deltax1099/DATN/Image/z3633867298325_d946b108812c51919a0d7c438a8485fa (1).jpg

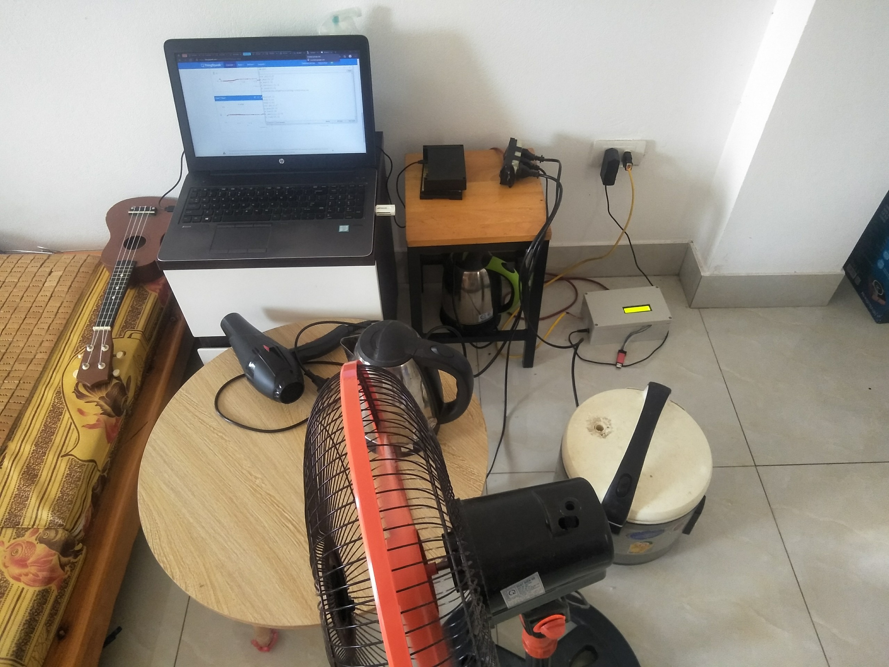
Image/z3633867298325_d946b108812c51919a0d7c438a8485fa (1).jpg
