deltax1099/DATN/Image/z3633789109134_f0cf5f153716a91d00ca48ec02b9b118.jpg

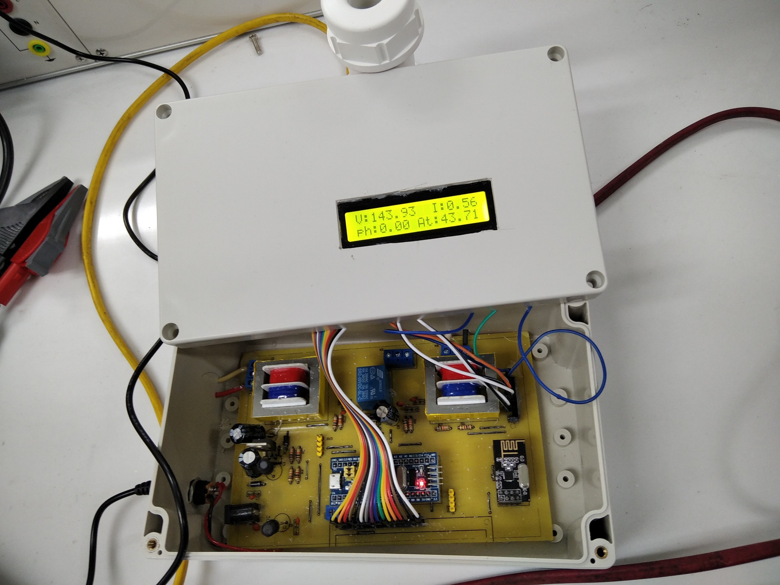
Image/z3633789109134_f0cf5f153716a91d00ca48ec02b9b118.jpg
