deltax1099/DATN/Document/note.pptx

LM2596T - 1N5819
AMS1117
R12: 10k
R13: 3k3
Bo sung word:
- Them khoi relay + bổ sung vào sơ đồ khối
- Gioi thieu cac giao thuc trong thiet ke phan mem nhung
- Thay doi ly thuyet cua phan thiet ke phan mem nhung (tinh toan
dai luong tren luoi dien) + thay đổi lưu đồ thuật toán
- Tài liệu tham khảo
- UI rms
- nguồn pin?
- U1 vs IN2? U2 vs IN1?
Nguon:
- Khong co cau chi bao ve trong truong hop qua dong/qua ap
- Dau vao jack DC cung khong co bao ve
- Jack DC dat o sau ic 5V => chi cung cap cho cac nguon 3.3V?
=> bien dong khong duoc cung cap => how to measure?
Bien dong:
- Khong cach li o bien dong => neu bien dong chay => chay thiet bi?

## Slide 2

EEPROM:
- Phan A tong, A luoi luu tren RAM neu mat dien thi mat luon? Neu gia tri qua lon thi bi tran?
Gateway:
- Them tin hieu nut nhan de dieu khien relay
Lưu đồ tt:
- Làm lại lưu đồ thuật toán chuẩn
- Giải thích code (từng dòng)
PCB:
- Do dong phan nguon va phan tin hieu
- Vẽ lại PCB của mạch để đo theo phương pháp chuẩn
Ứng dụng:
- Lắp đặt thiết bị như thế nào trong hệ thống nhà?

## Slide 3

- Thêm khối relay + bổ sung vào sơ đồ khối
- Thêm phần pcb theo phương pháp chuẩn
- Thử nghiệm sai số đo chính xác
- Làm rõ tương quan thời điểm lấy mẫu u và I
- Làm rõ sử dụng Arduino trên gateway
- Làm rõ việc không tập trung vào độ chính xác mà tập trung xây dựng chức năng
- Làm rõ việc thiết kế công tơ 2 chiều công suất
- Bổ sung kết quả trong lưới điện thông minh
- Làm rõ có thiết kế tính năng trong lưới điện thông minh
  - Lập chi tiết kịch bản thử nghiệm
  - Tiến hành lần lượt, có sơ đồ, chú thích trên ảnh
  - Cái nào chưa có thì ghi rõ thiếu thiết bị gì…
  - Hạn chế

## Slide 4

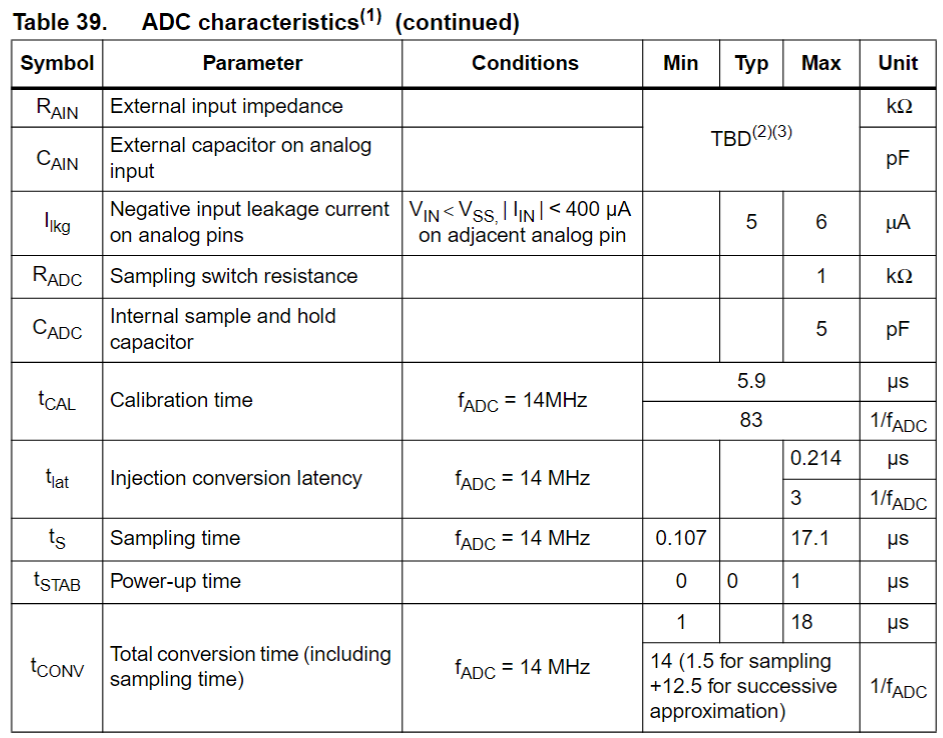
[picture p4: figure]
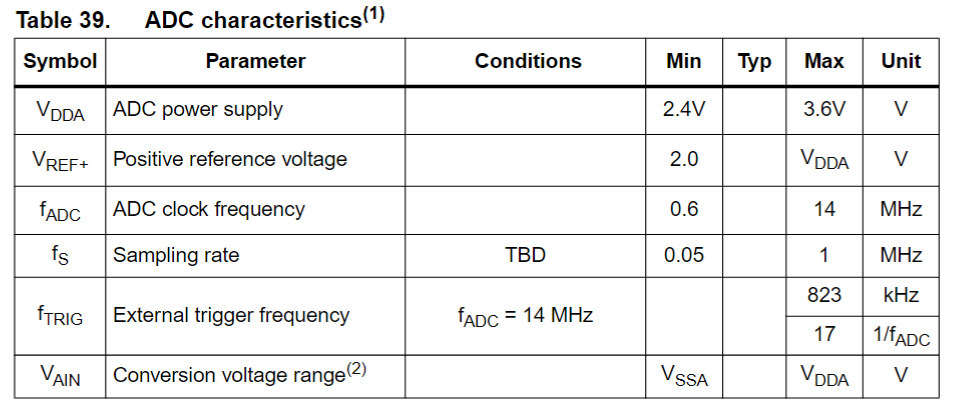
[picture p5: figure]
