deltax1099/DATN/Document/image-datn.pptx

Phân tích yêu cầu thiết kế

Thiết kế phần cứng và
phần mềm

Mô phỏng

Chế tạo thiết bị

Thử nghiệm và
đánh giá

## Slide 2

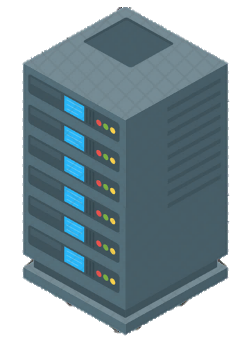
[picture p6: figure]
Data Storage Server Icon of Isometric style - Available in SVG, PNG, EPS, AI & Icon fonts

Server

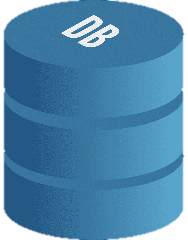
[picture p7: figure]
Round blue and white illustration, Database Server Icon, Database Symbol, template, user Interface Design, computer Program png | PNGWing

Database

Thành phần hệ thống

Thiết bị thu thập dữ liệu

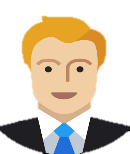
[picture p8: figure]

Công tơ điện

Công tơ điện

…

Quản lý

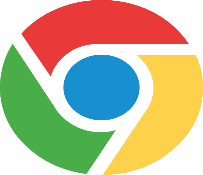
[picture p9: figure]

Web

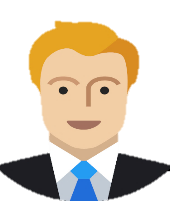
[picture p10: figure]

Web quản lý

Hộ gia đình

Web

Server

Công tơ điện

Công tơ điện

Cơ sở dữ liệu

Thiết bị thu thập dữ liệu

## Slide 3

THIẾT BỊ CÔNG TƠ ĐIỆN TỬ

Khối hiển thị

Khối nguồn

Khối SD Card

Khối đo dòng điện/điện áp

Khối điều khiển

Khối truyền thông RF

## Slide 4

Khối nguồn

5V

5V

3.3V

5V

3.3V

Khối hiển thị

Khối đo dòng điện/điện áp

I2C

MCU
STM32F1

SPI

Khối SD Card

Khối truyền thông RF

ADC

SPI

## Slide 5

THIẾT BỊ THU THẬP DỮ LIỆU

Khối điều khiển

Khối truyền thông Wifi

Khối truyền thông RF

## Slide 6

Nguồn

3.3V

3.3V

3.3V

MCU
Arduino Uno

UART

Khối truyền thông Wifi

Khối truyền thông RF

SPI

## Slide 7

Khối đo

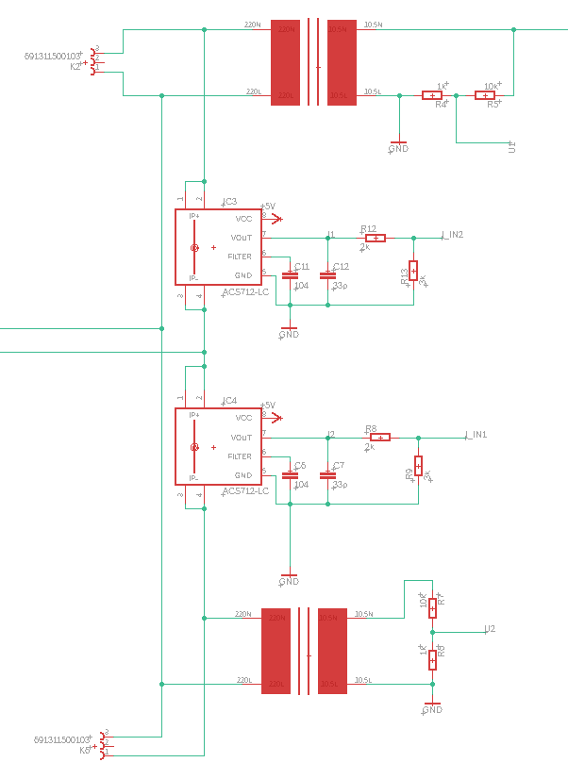
[picture p11: figure]

Nguồn

## Slide 8

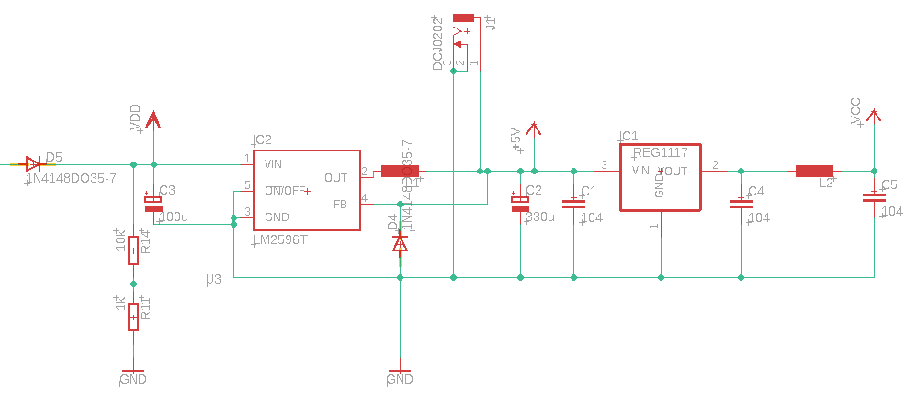
[picture p12: figure]

## Slide 9

Nguồn MT

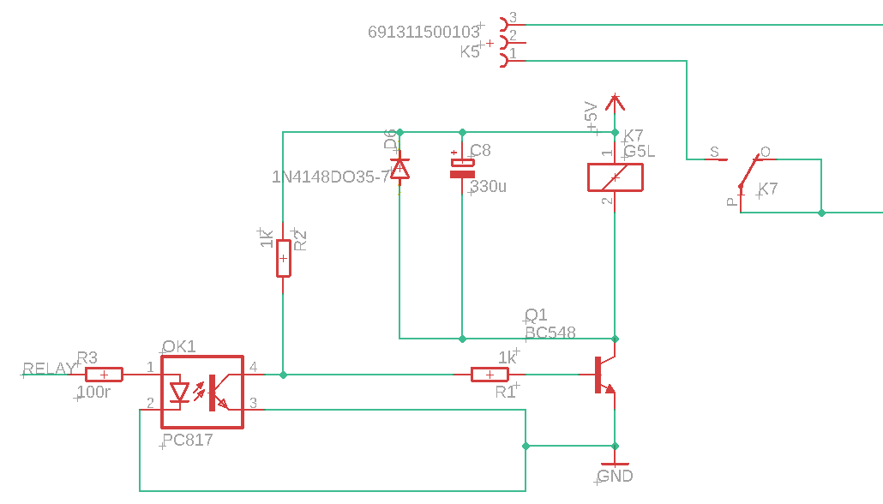
[picture p13: figure]

## Slide 10

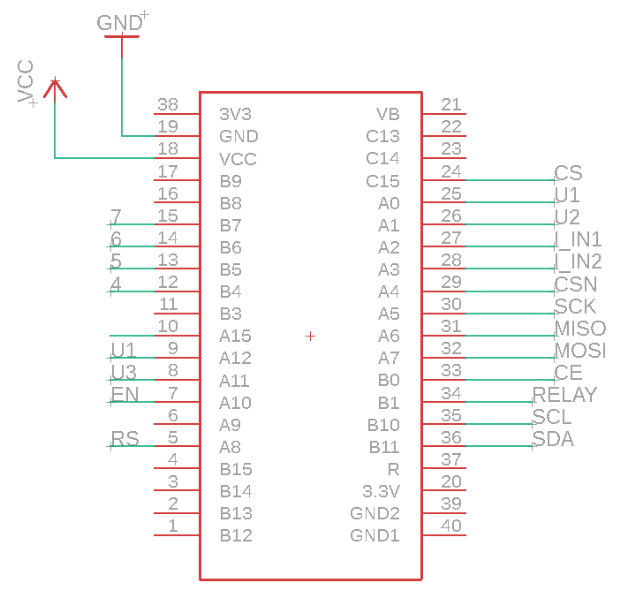
[picture p14: figure]
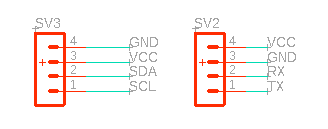
[picture p15: figure]

## Slide 11

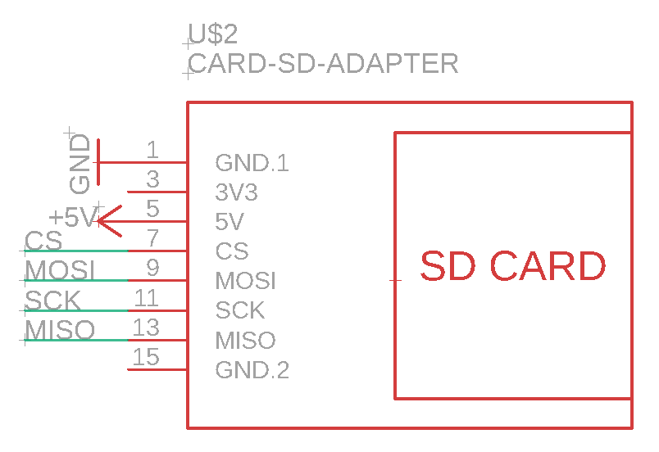
[picture p16: figure]
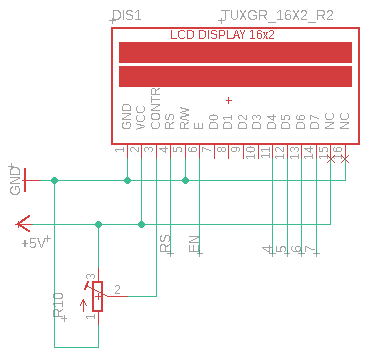
[picture p17: figure]
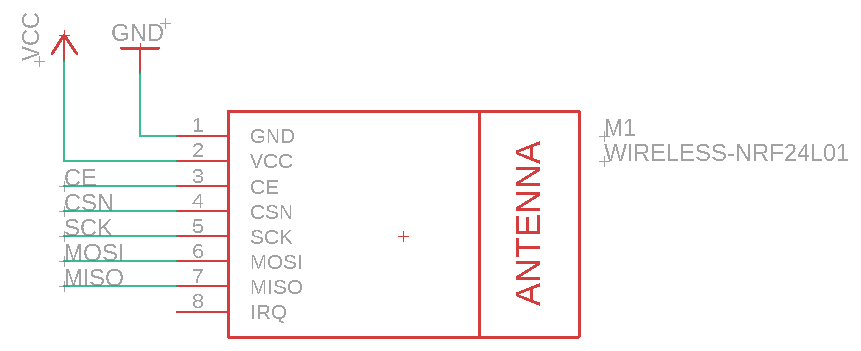
[picture p18: figure]

## Slide 12

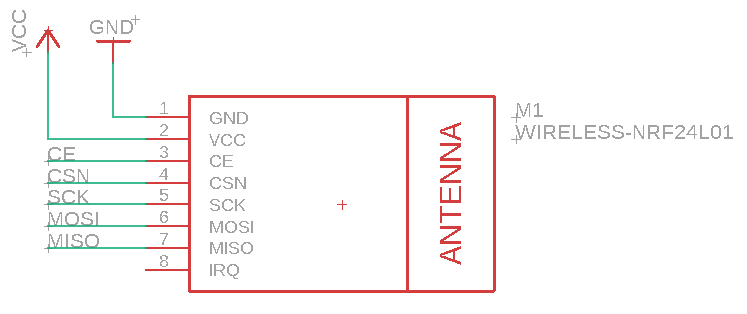
[picture p19: figure]

ESP8266

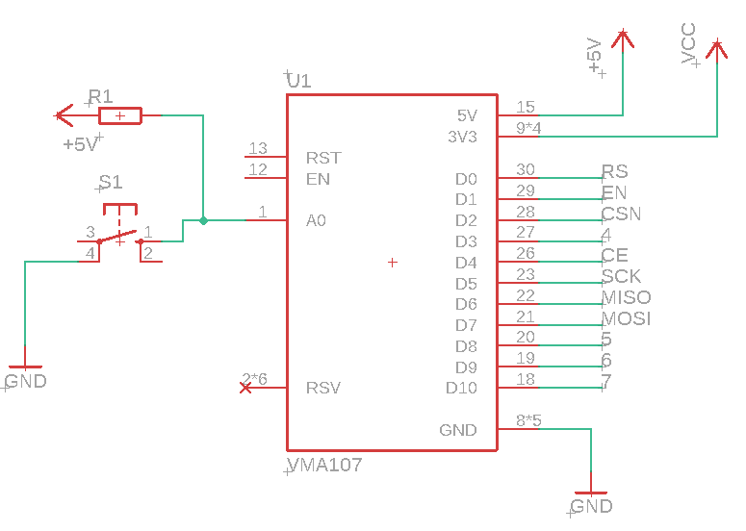
[picture p20: figure]
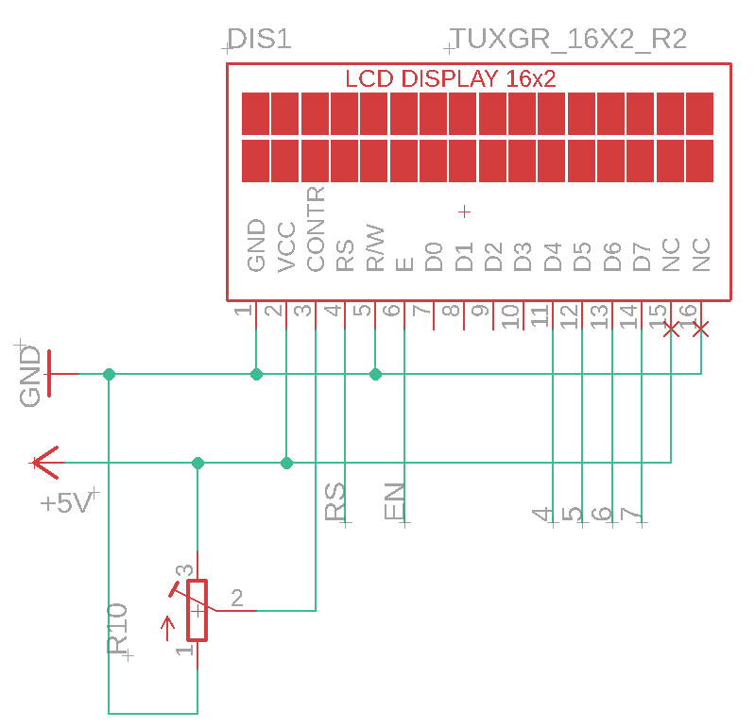
[picture p21: figure]

## Slide 13

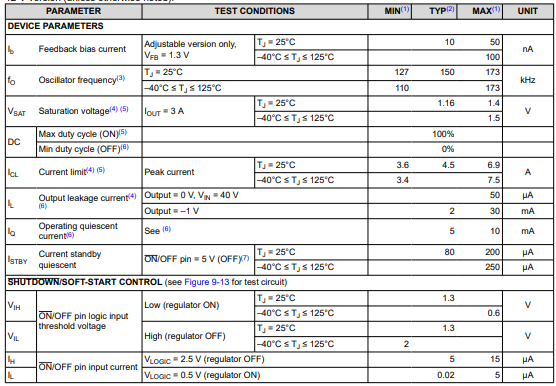
[picture p22: figure]

## Slide 14

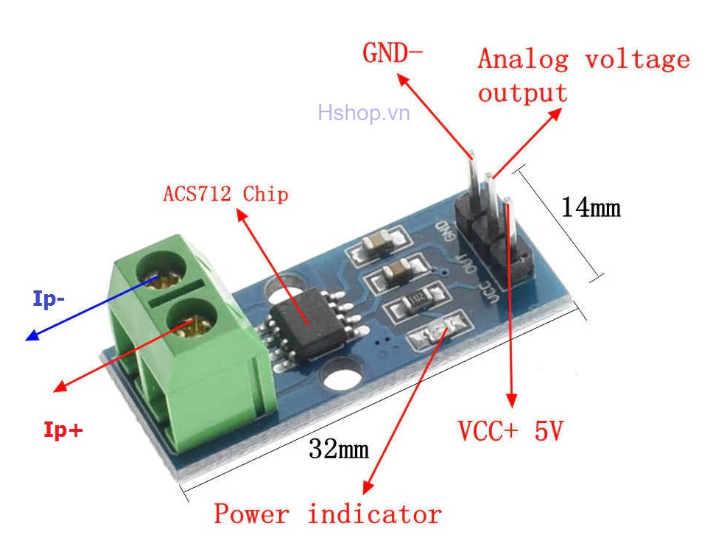
[picture p23: figure]

## Slide 15

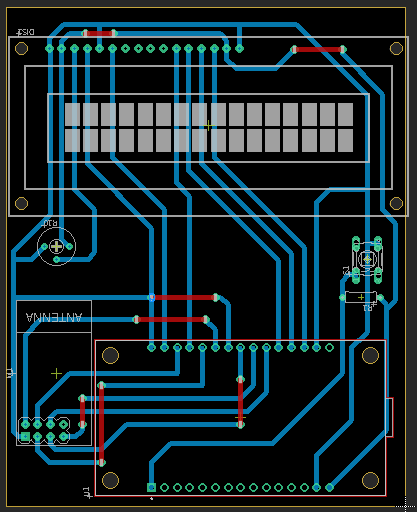
[picture p24: figure]
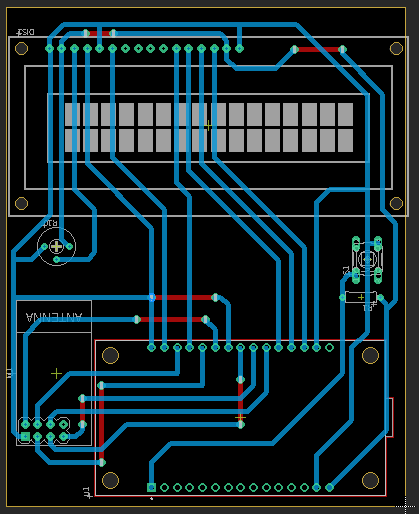
[picture p25: figure]

## Slide 16

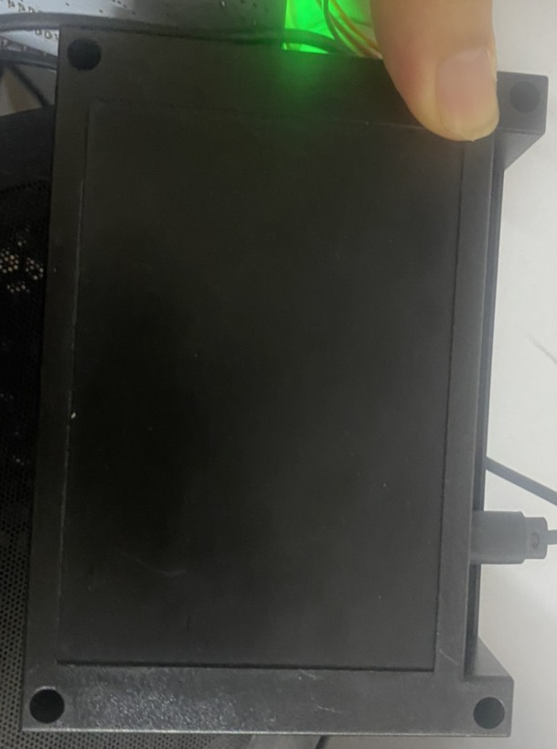
[picture p26: figure]
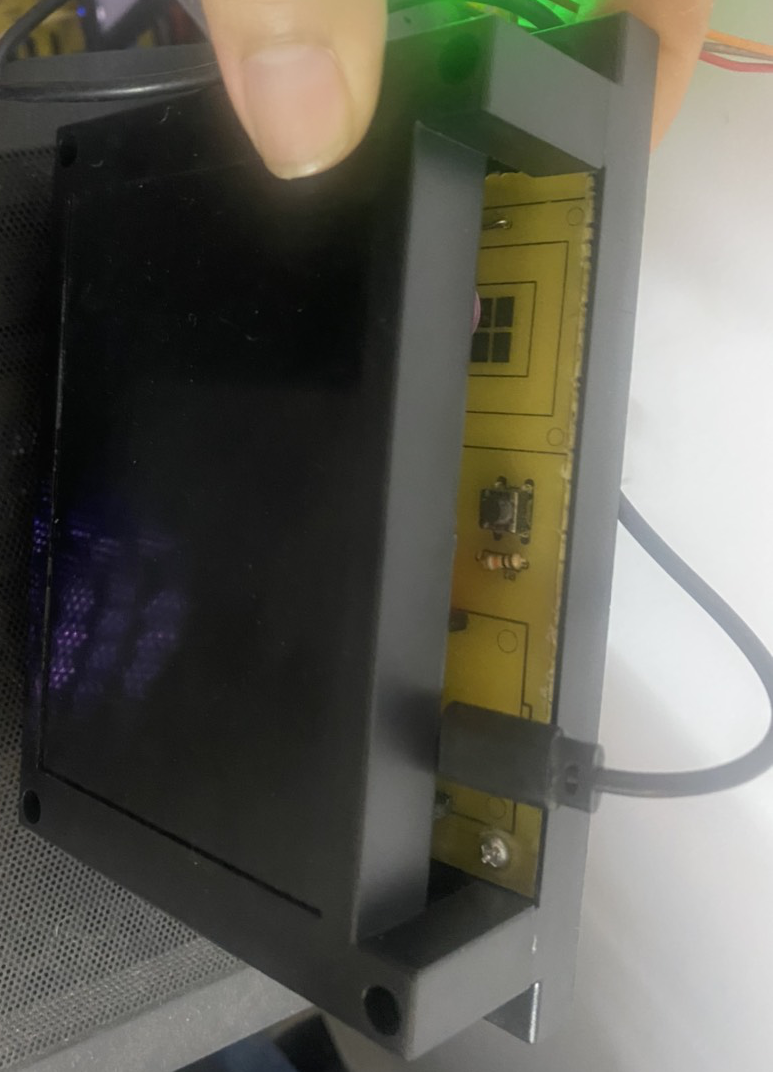
[picture p27: figure]

## Slide 17

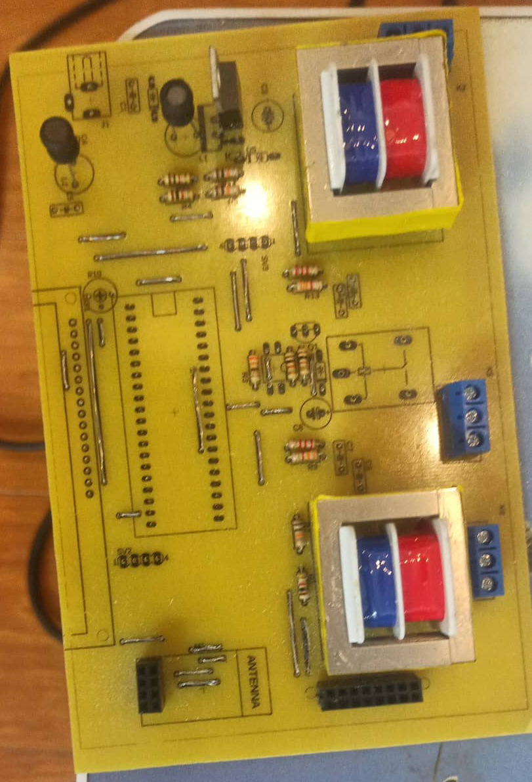
[picture p28: figure]
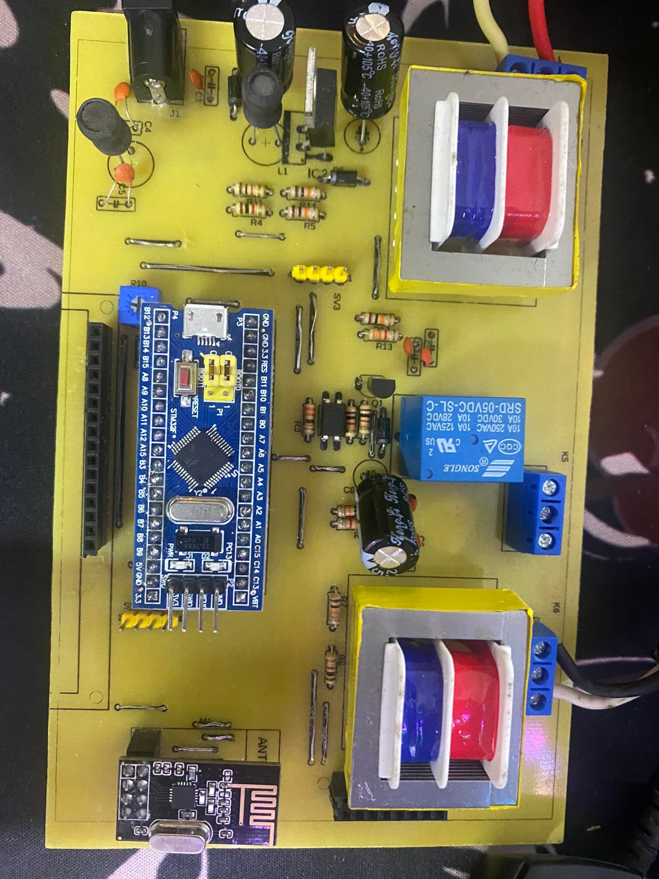
[picture p29: figure]

Trên lưới dưới tải

## Slide 18

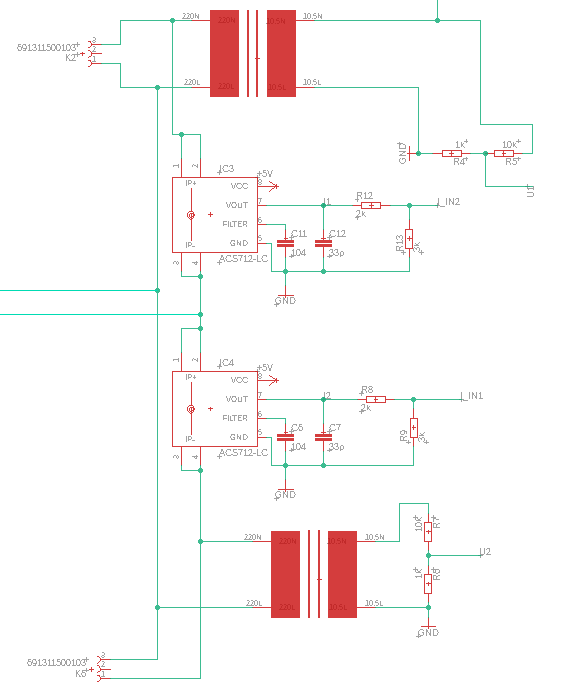
[picture p30: figure]

## Slide 19

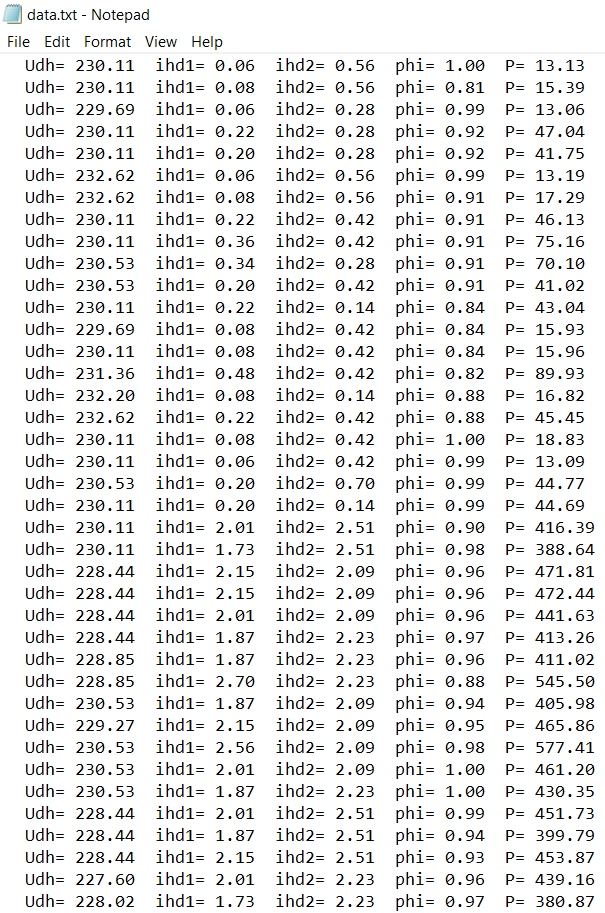
[picture p31: figure]
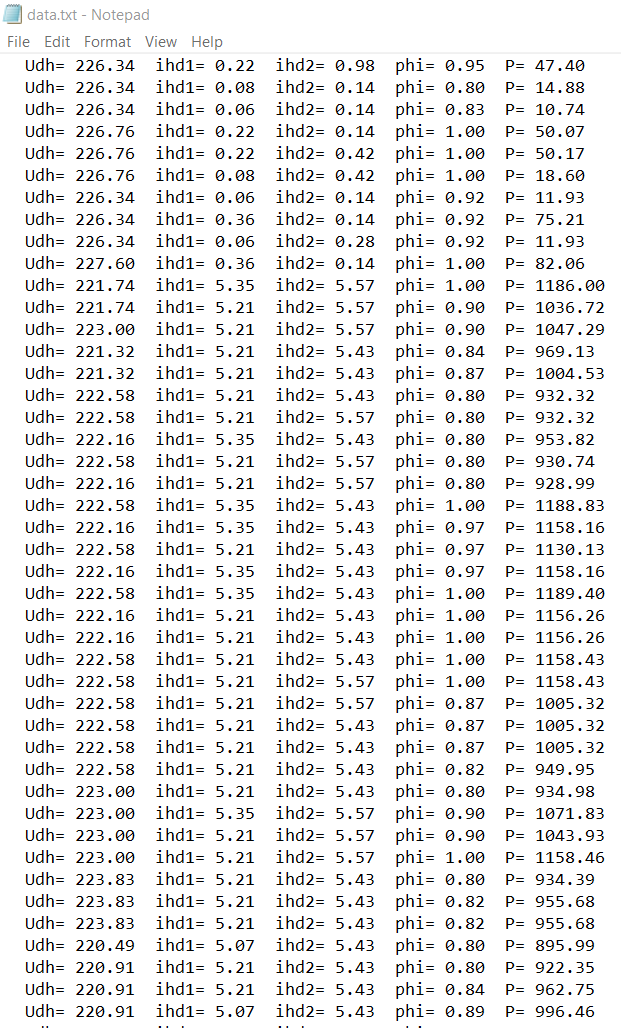
[picture p32: figure]

## Slide 20

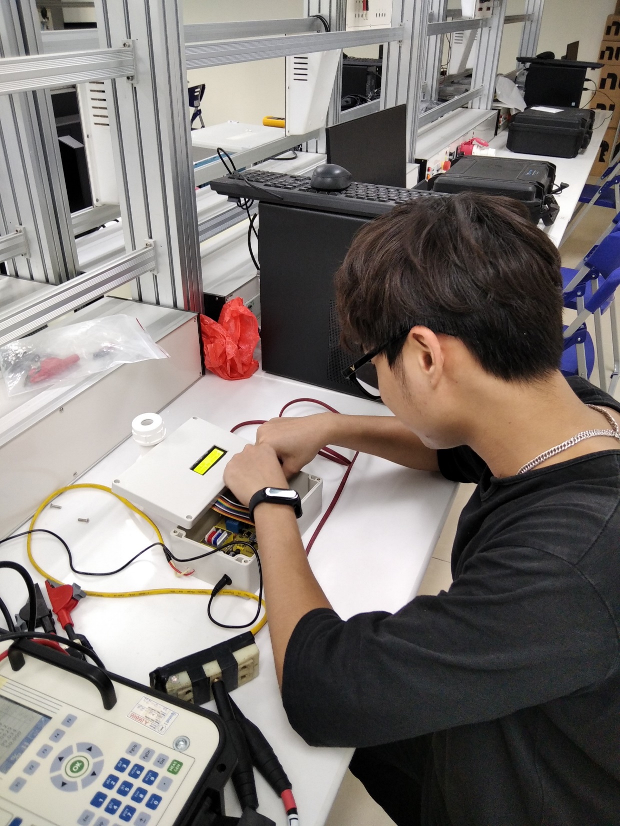
[picture p33: figure]
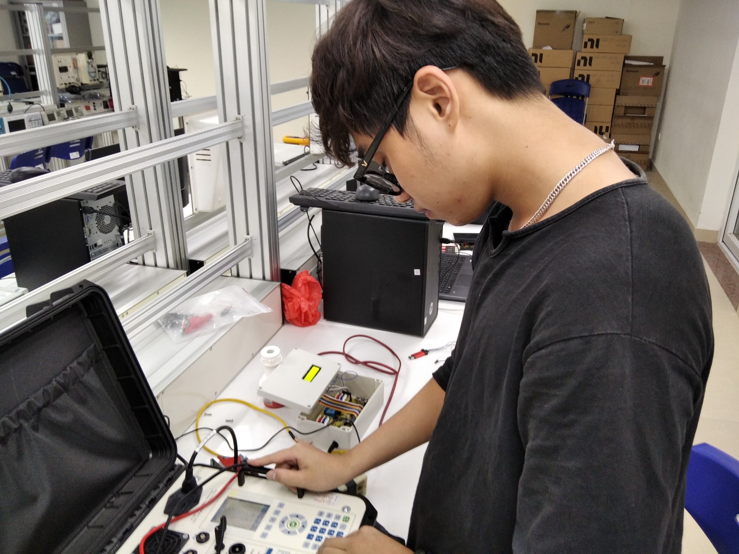
[picture p34: figure]

## Slide 21

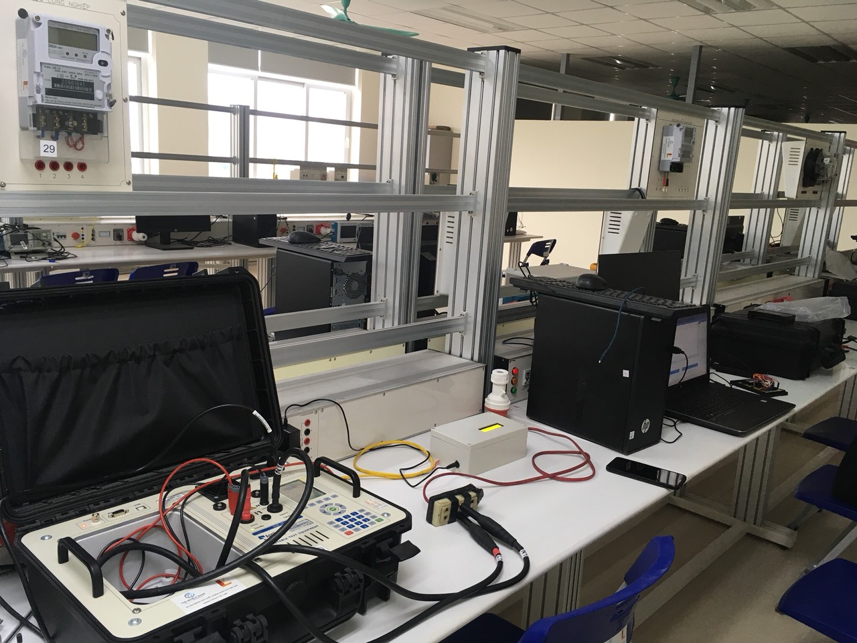
[picture p35: figure]

## Slide 22

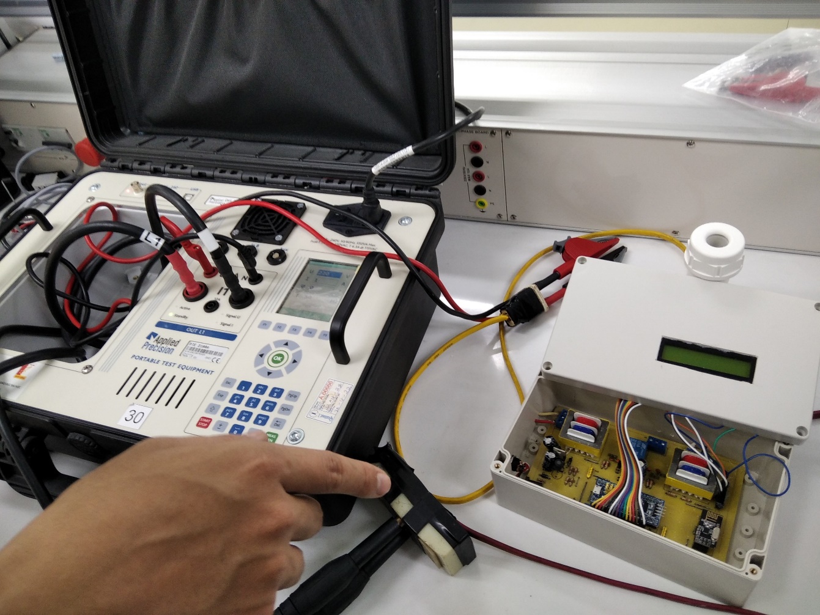
[picture p36: figure]
