deltax1099/DATN/Document/ĐATN_PPTX.pptx

## Đồ án tốt nghiệp Thiết kế công tơ điện tử trong hệ thống lưới điện thông minh

Giáo viên hướng dẫn: PGS.TS Hoàng Sĩ Hồng

Sinh viên thực hiện: Trần Anh Dũng – 20173785

## Table of Contents 01

Mục lục

02

Tổng quan đề tài

Thiết kế hệ thống

03

04

Thiết kế phần cứng

Thiết kế phần mềm

05

## I. Tổng quan đề tài

Tổng quan công nghệ

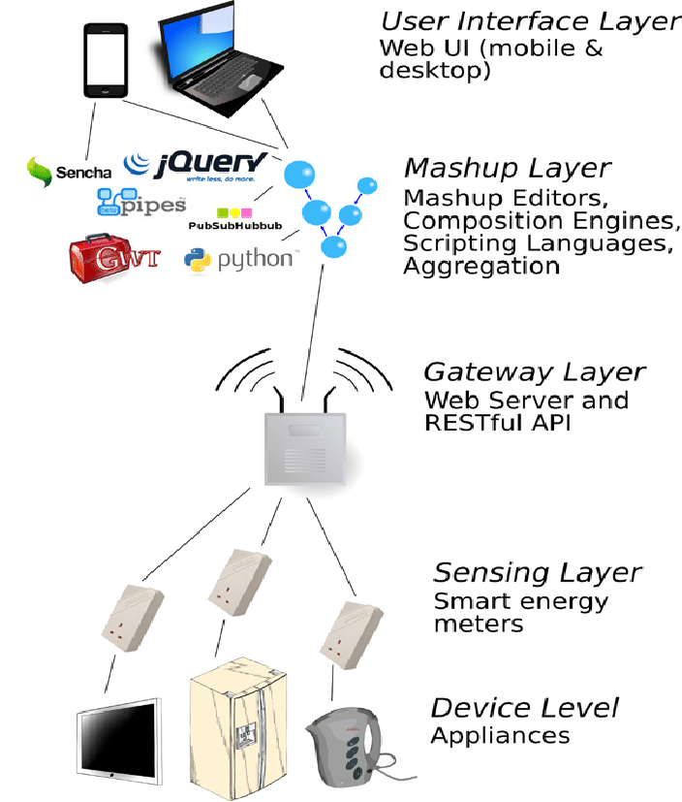
[picture p37: figure]

- Công nghệ IoT ngày càng phát triển
- Công tơ điện truyền thống hiện nay còn nhiều hạn chế

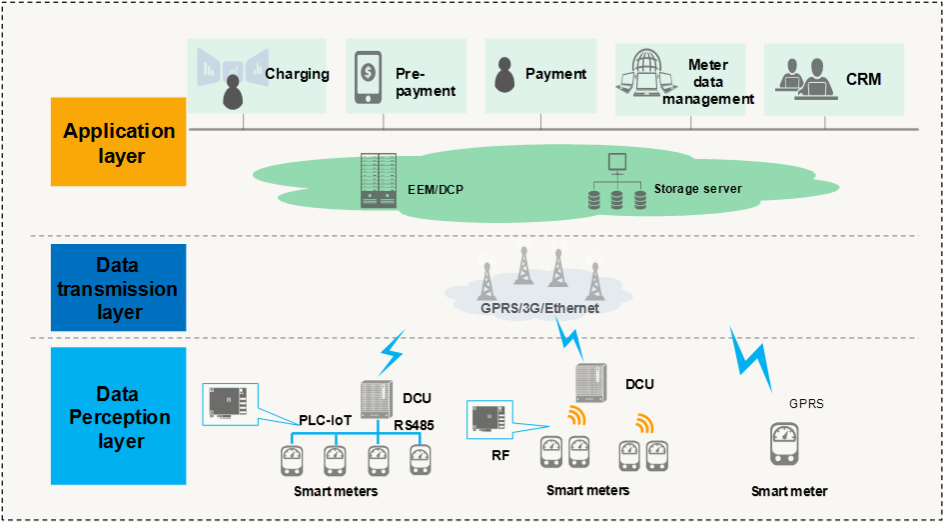
[picture p38: figure]

## I. Tổng quan đề tài

Tổng quan hệ thống

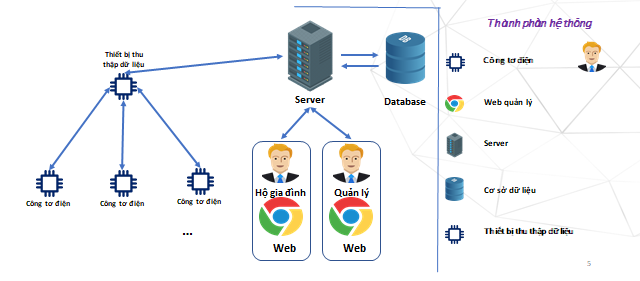
[picture p39: figure]

## II. Thiết kế hệ thống

Sơ đồ khối hệ thống

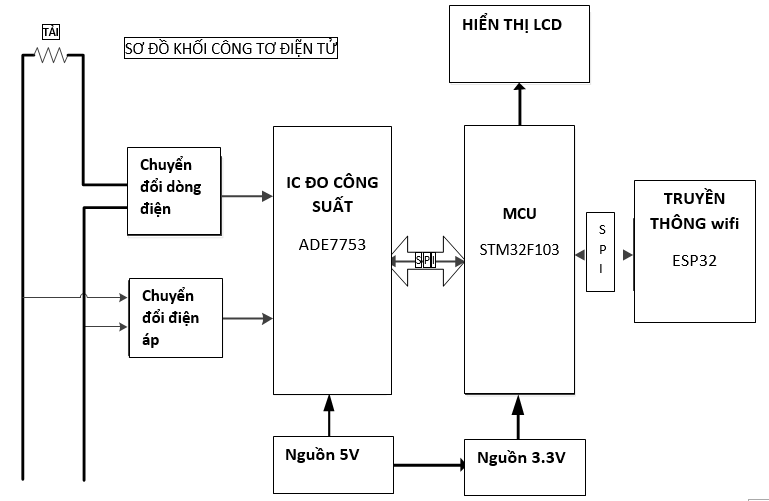
[picture p40: figure]

## III.Thiết kế phần cứng – 1. Khối nguồn

Sơ đồ nguyên lý

- Tích hợp trực tiếp trong bo mạch (lấy trực tiếp từ nguồn lưới điện 220V).
- Đầu vào: 220VAC
- Đầu ra: 5VDC cho mạch ADE7753, khối LCD và 3.3VDC cho mạch STM32F103 và khối truyền thông ESP32.

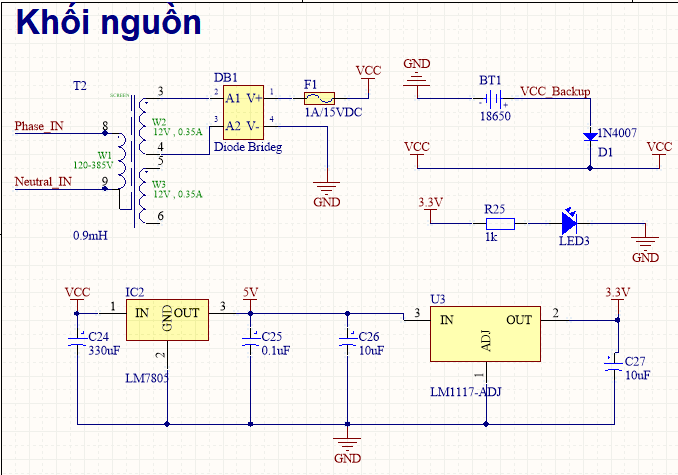
[picture p41: figure]

## III.2. Khối vi điều khiển

Sơ đồ nguyên lý

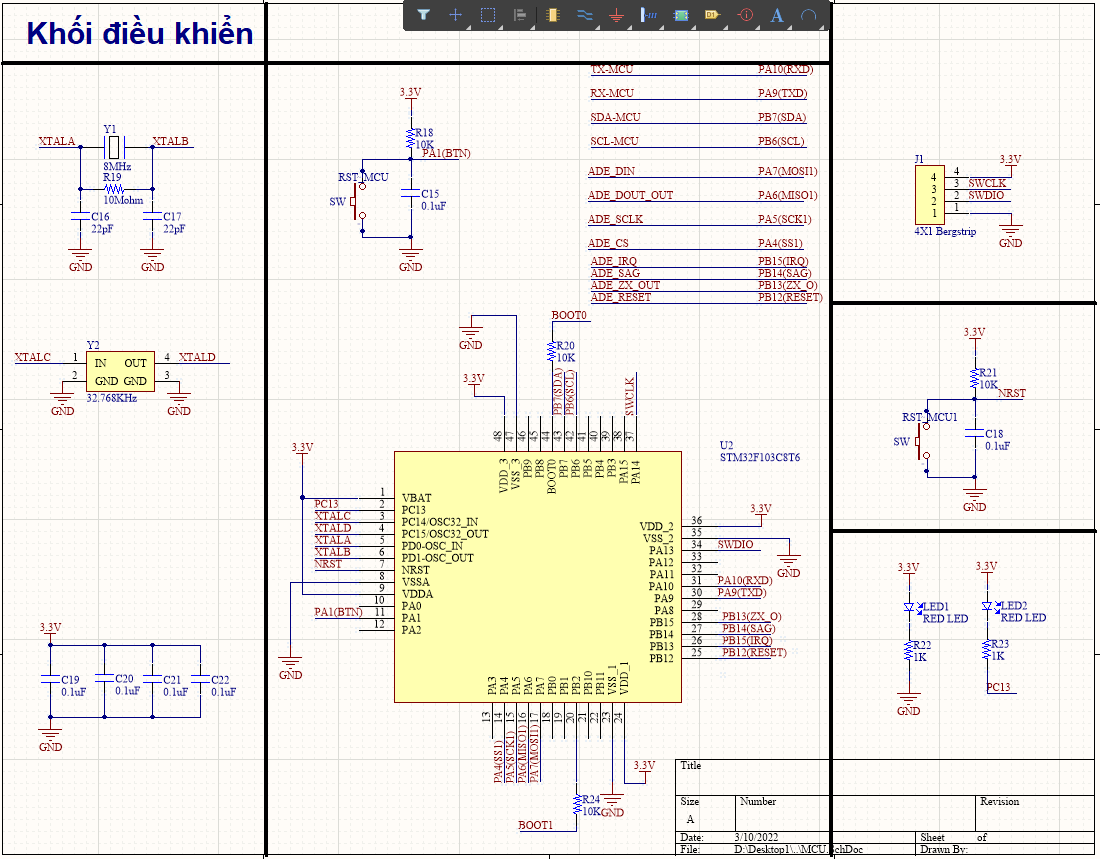
[picture p42: figure]

- Có tối thiểu 1 cổng giao tiếp SPI để kết nối với ADE7753 và 1 cổng UART để kết nối với modul ESP32.
- Có RTC bên trong Chip để phục vụ việc tính toán điện năng tiêu thụ theo biểu giá.
- Tiêu thụ điện năng thấp.
- Giá thành hợp lý.

## III.3. Khối chuyển đổi dòng điện – điện áp

Sơ đồ nguyên lý

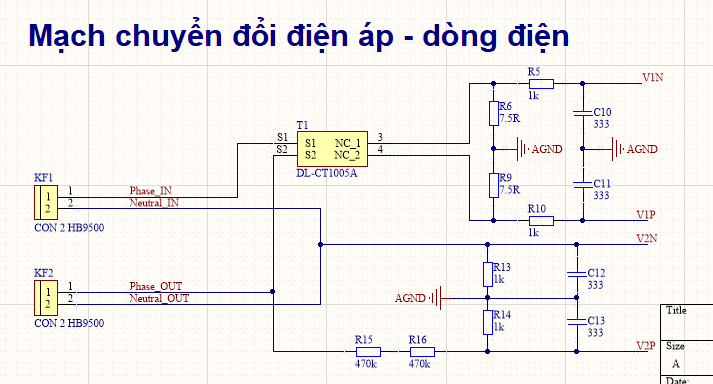
[picture p43: figure]

## III.4. Khối IC đo công suất ADE7753

Sơ đồ nguyên lý

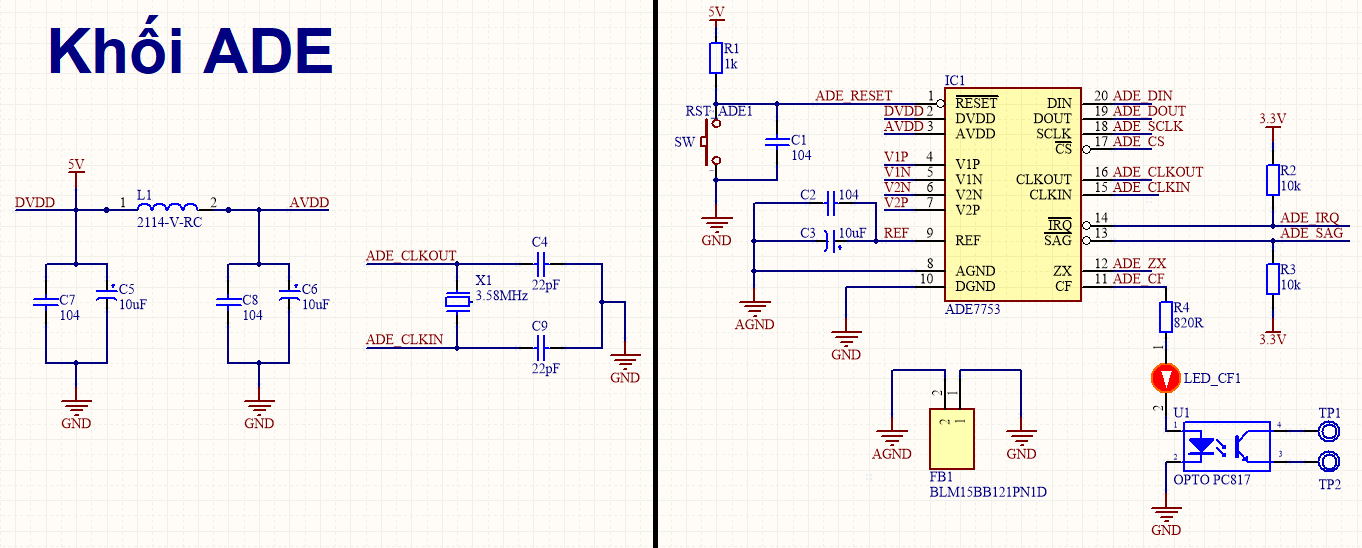
[picture p44: figure]
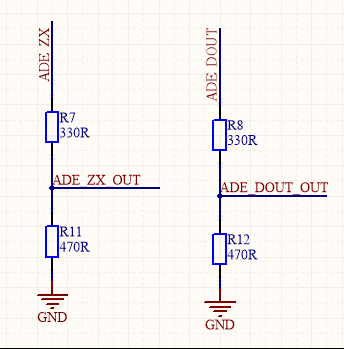
[picture p45: figure]

## III.5. Khối hiển thị

Sơ đồ nguyên lý

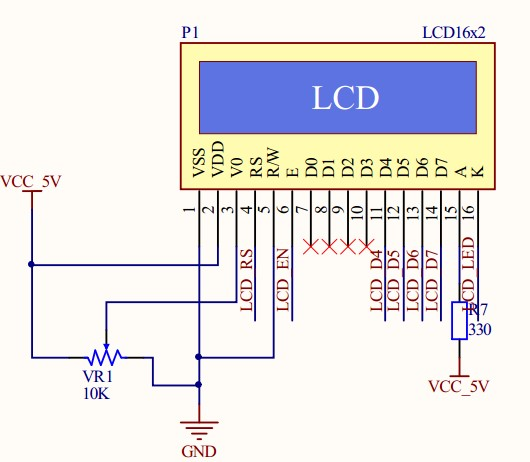
[picture p46: figure]

## III.6. Khối truyền thông không dây

Sơ đồ nguyên lý

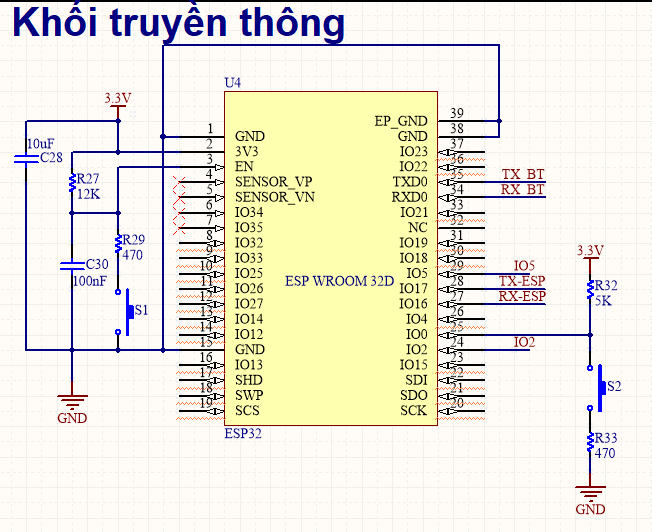
[picture p47: figure]
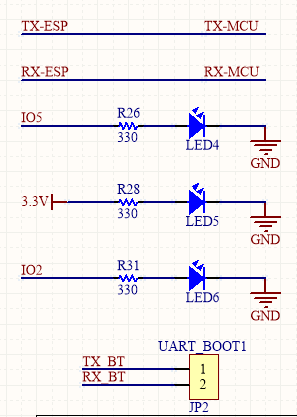
[picture p48: figure]

## IV. Thiết kế phần mềm

Lưu đồ thuật toán chương trình chính

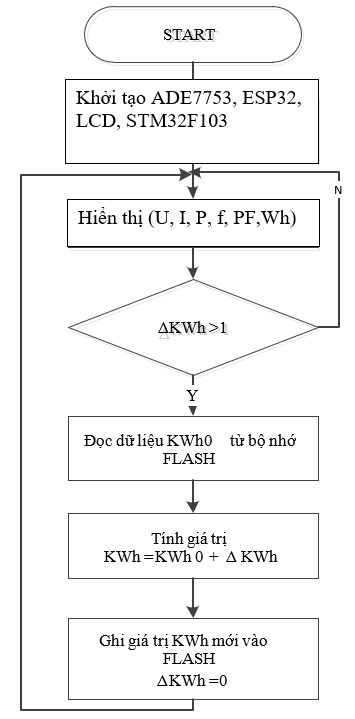
[picture p49: figure]

Gửi dữ liệu qua ESP32

## IV. Thiết kế phần mềm

Lưu đồ thuật toán chương trình ngắt phục vụ tính toán các đại lượng của công tơ

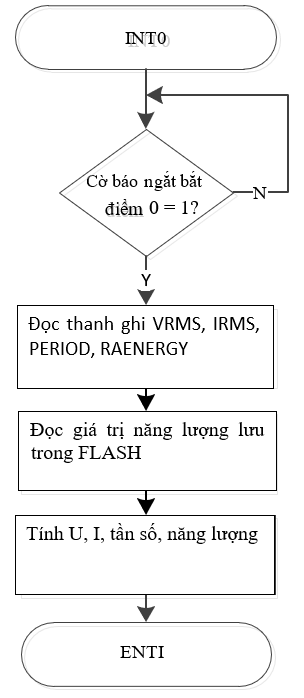
[picture p50: figure]

## IV. Thiết kế phần mềm

Lưu đồ thuật toán chương trình gửi dữ liệu lên server của ESP32

START

Khởi tạo UART, truyền thông wifi, MQTT service

- Sử dụng hệ điều hành RTOS
- 2 tác vụ: UART Task nhận dữ liệu từ vi điều khiển và MQTT Task gửi dữ liệu lên server

UART Task

Rx Buffer nhận data

Gửi vào Global Buffer

MQTT Task

Global Buffer nhận data

Gửi lên Server bằng mqttsend()

NO

NO

YES

YES

## Slide 15

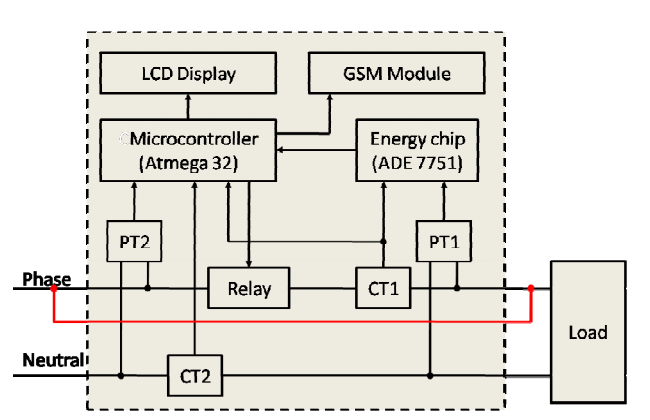
[picture p51: figure]
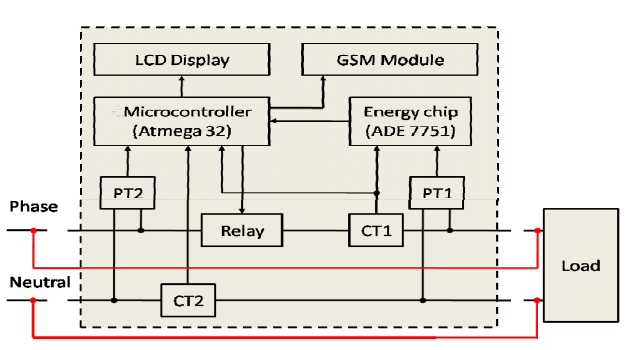
[picture p52: figure]

## Slide 16

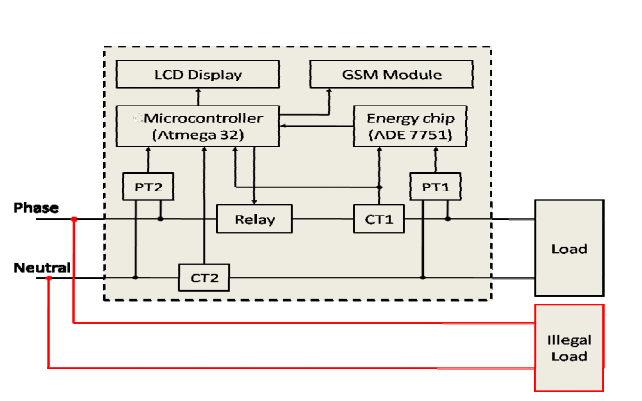
[picture p53: figure]
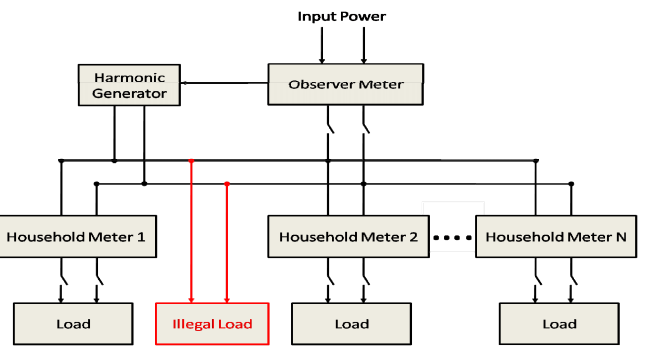
[picture p54: figure]

## Slide 17

THANKS FOR WATCHING!
