deltax1099/DATN/Image/Blank_diagram.png

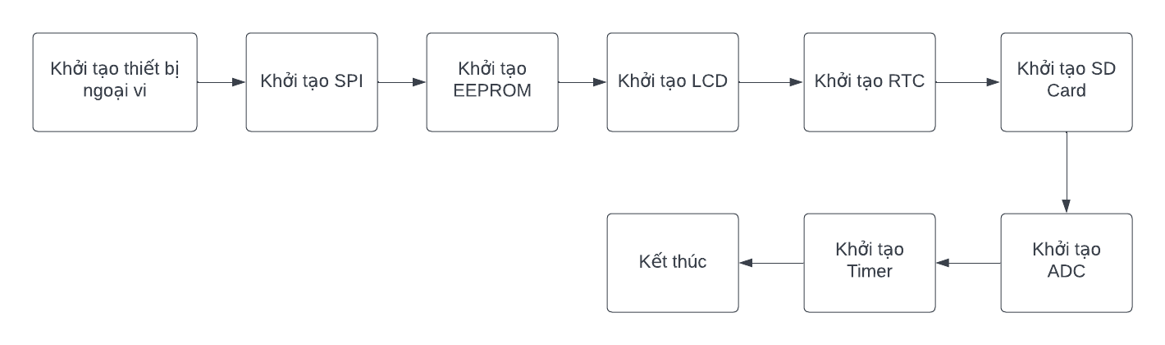
Image/Blank_diagram.png
