deltax1099/DATN/Image/diagram_esp.png

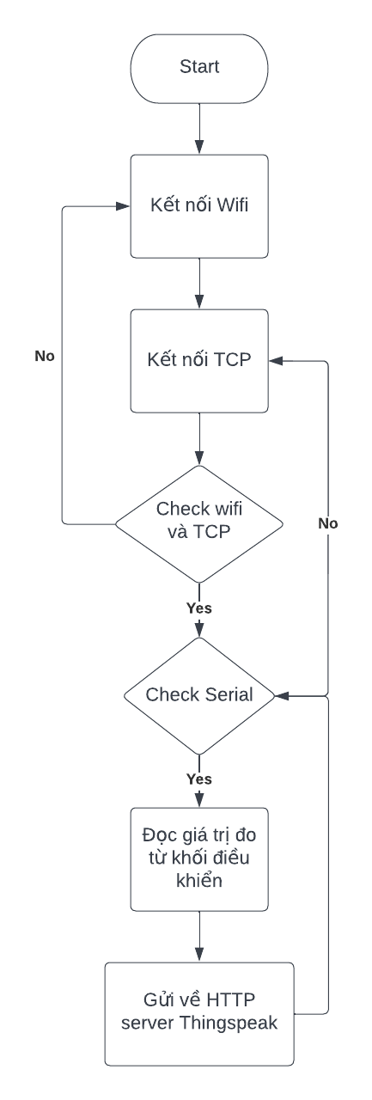
Image/diagram_esp.png
