deltax1099/DATN/Image/diagram_gateway.png

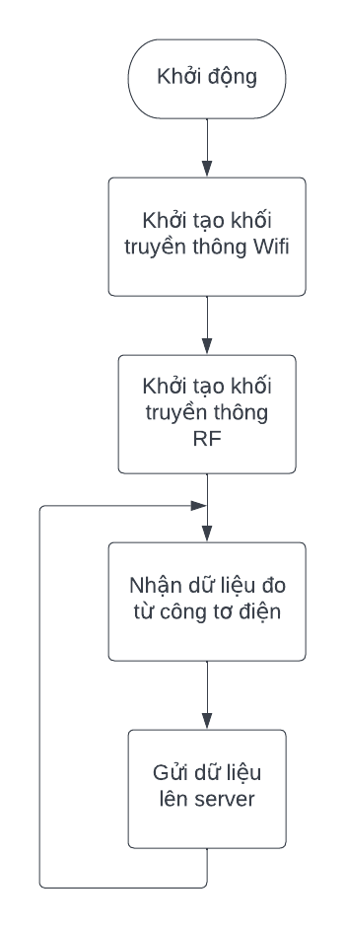
Image/diagram_gateway.png
