deltax1099/DATN/Image/diagram_meter1.png

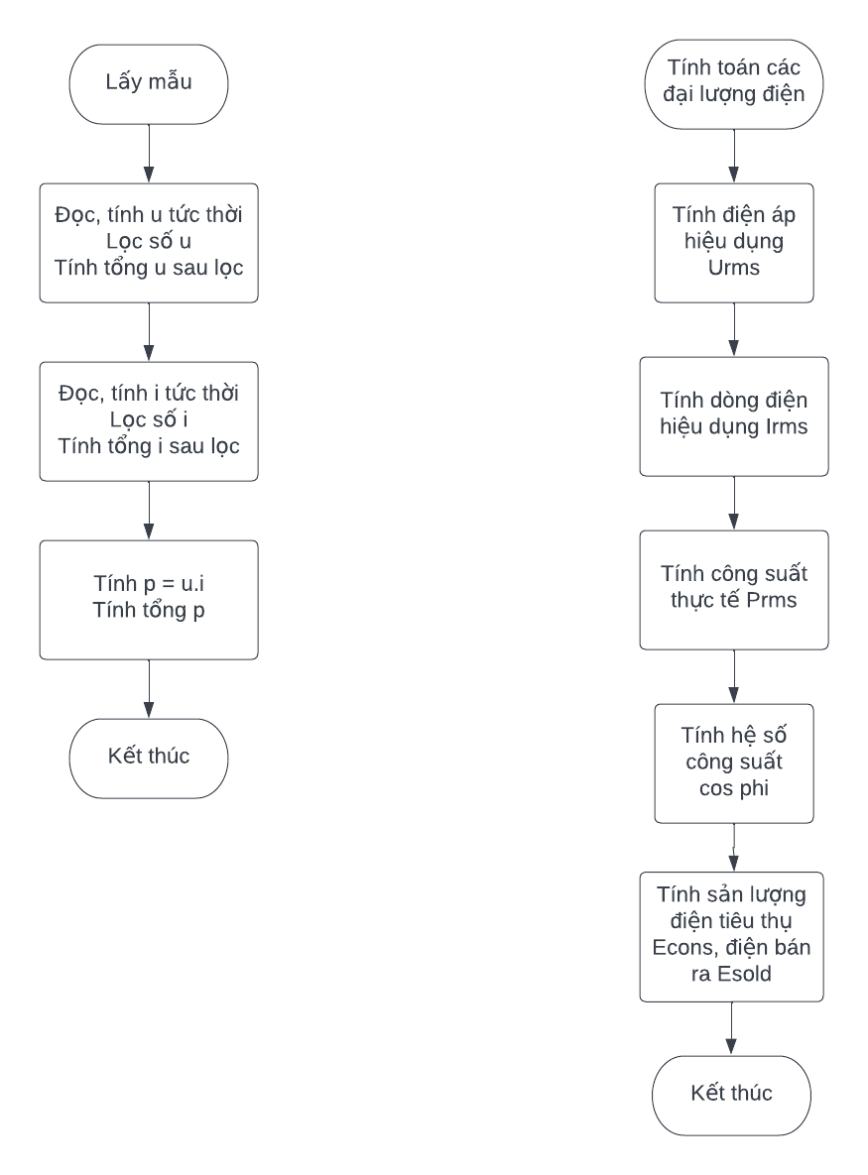
Image/diagram_meter1.png
