deltax1099/DATN/Image/diagram_meter.png

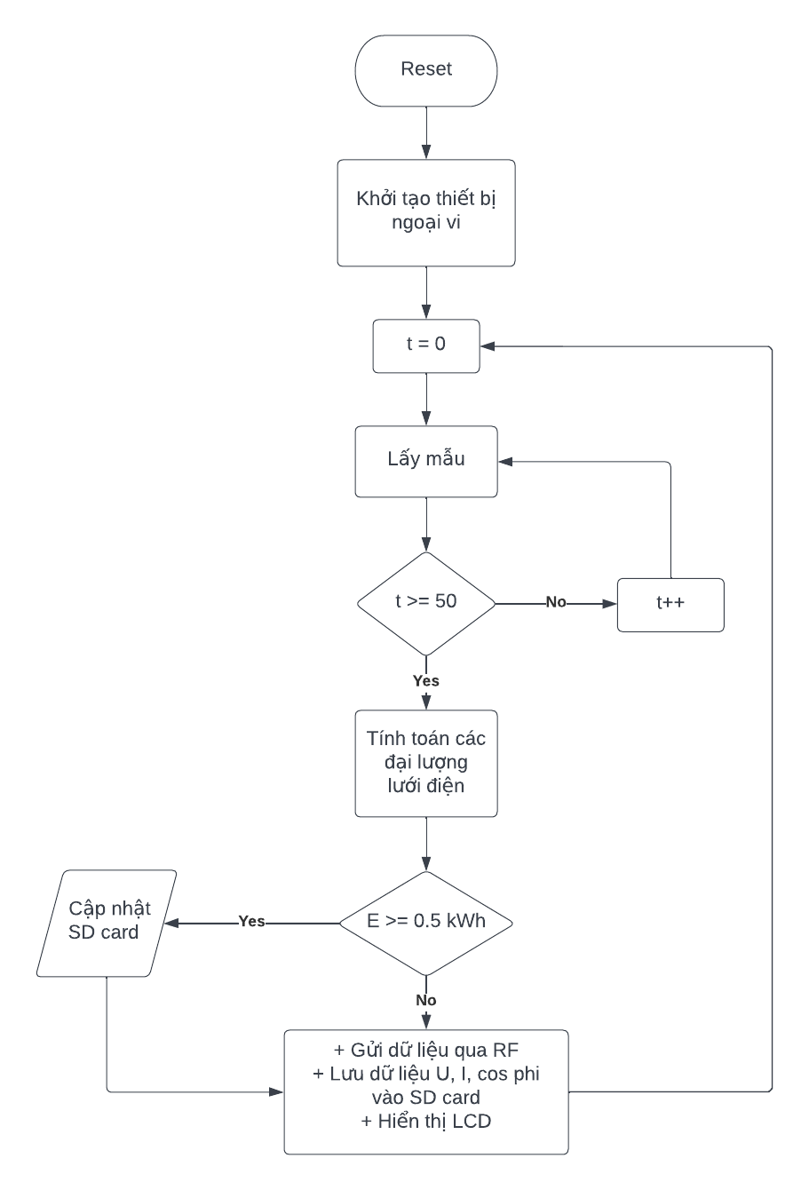
Image/diagram_meter.png
