deltax1099/DATN/Image/Gateway_dv1.jpg

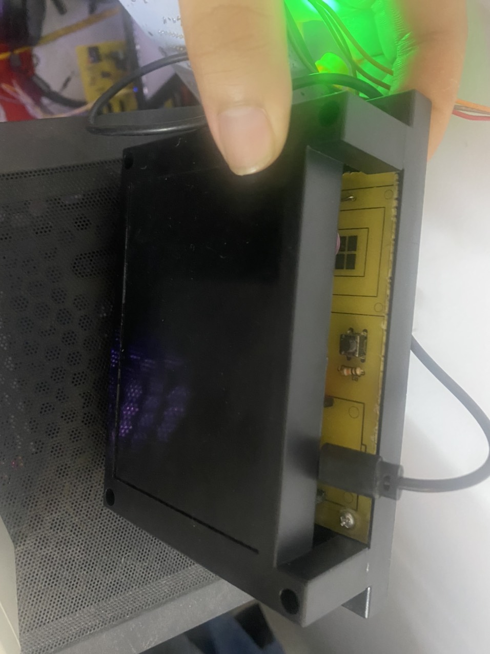
Image/Gateway_dv1.jpg
