deltax1099/DATN/Image/Gateway_dv.jpg

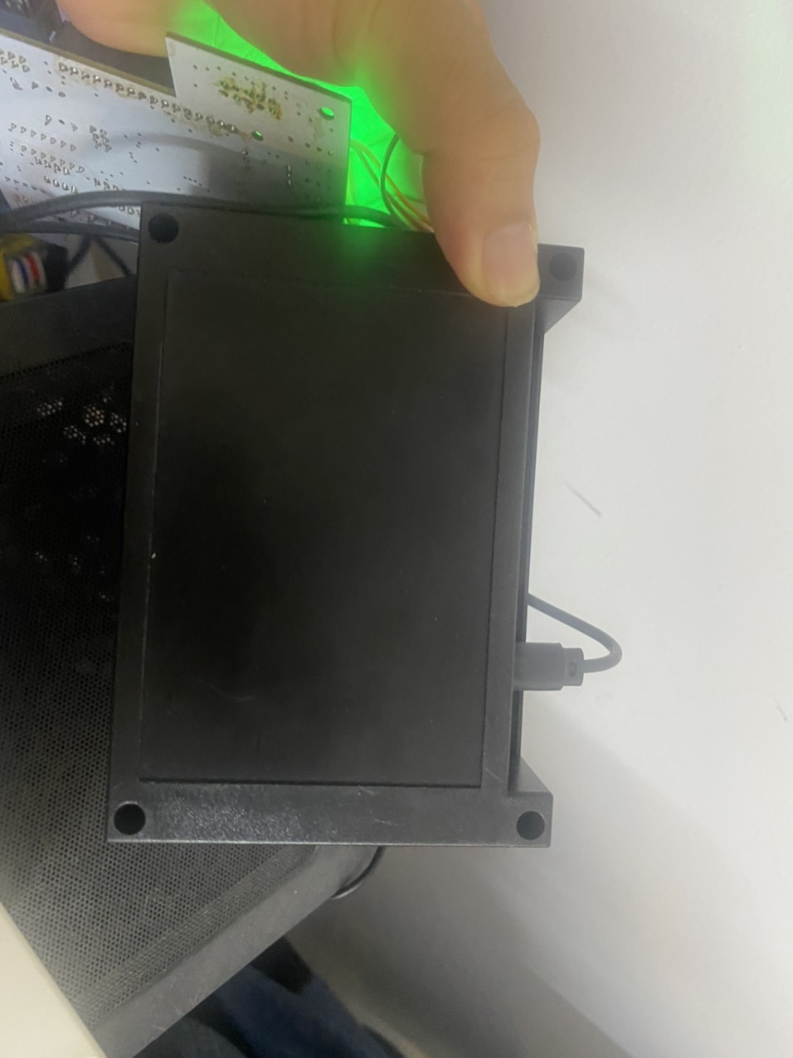
Image/Gateway_dv.jpg
