deltax1099/DATN/Image/Gateway_pcb.jpg

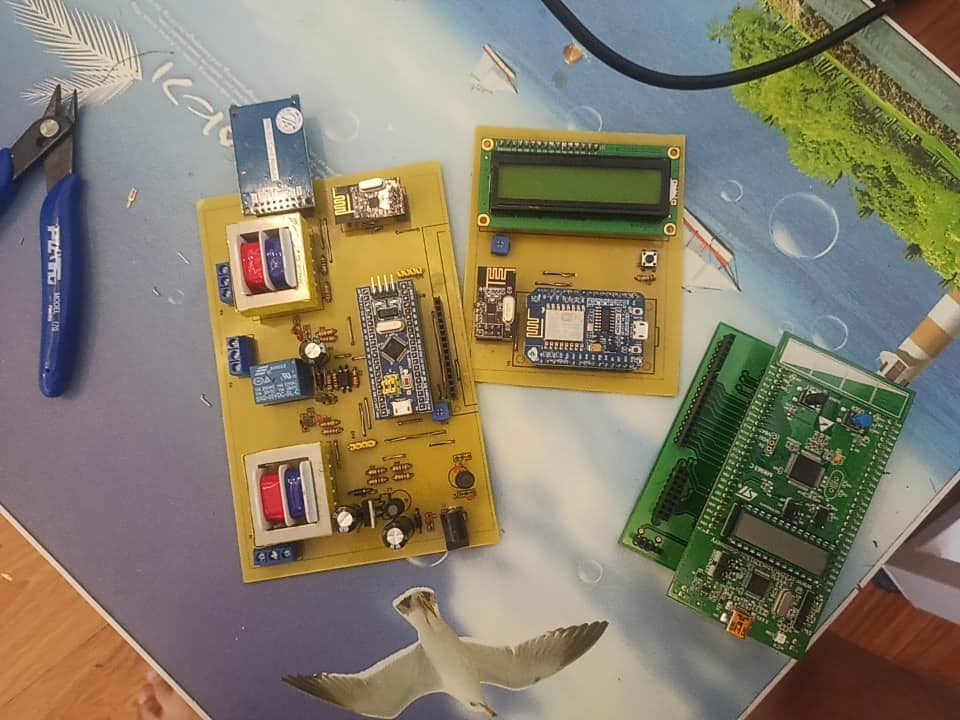
Image/Gateway_pcb.jpg
