deltax1099/DATN/Image/Meter_dv.jpg

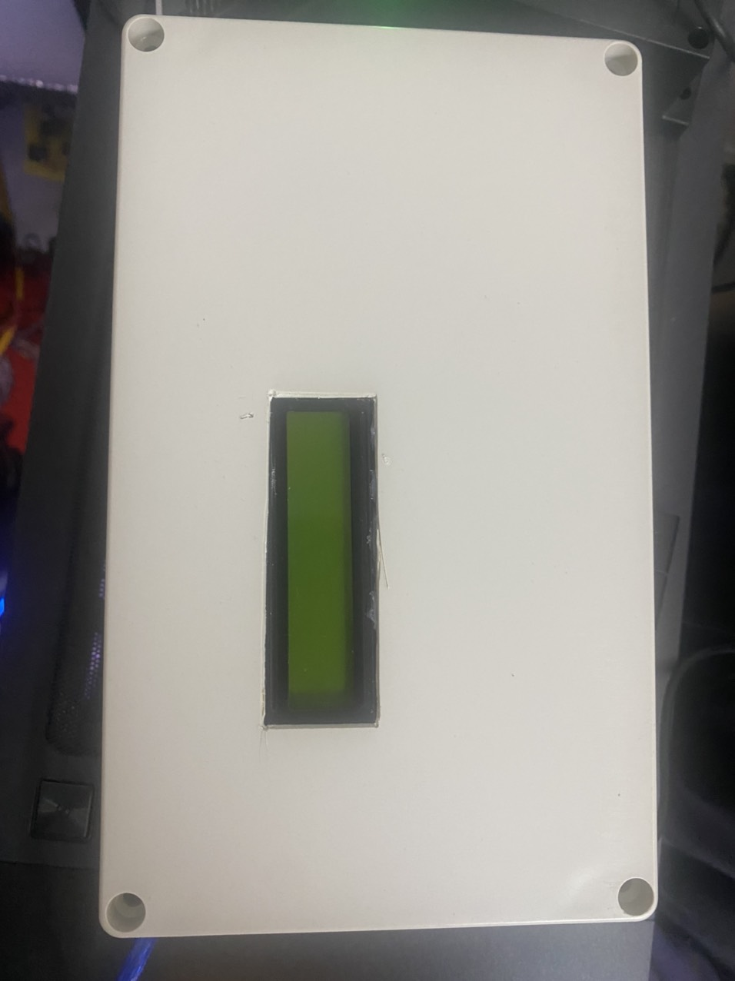
Image/Meter_dv.jpg
