deltax1099/DATN/Image/Meter_pcb1.jpg

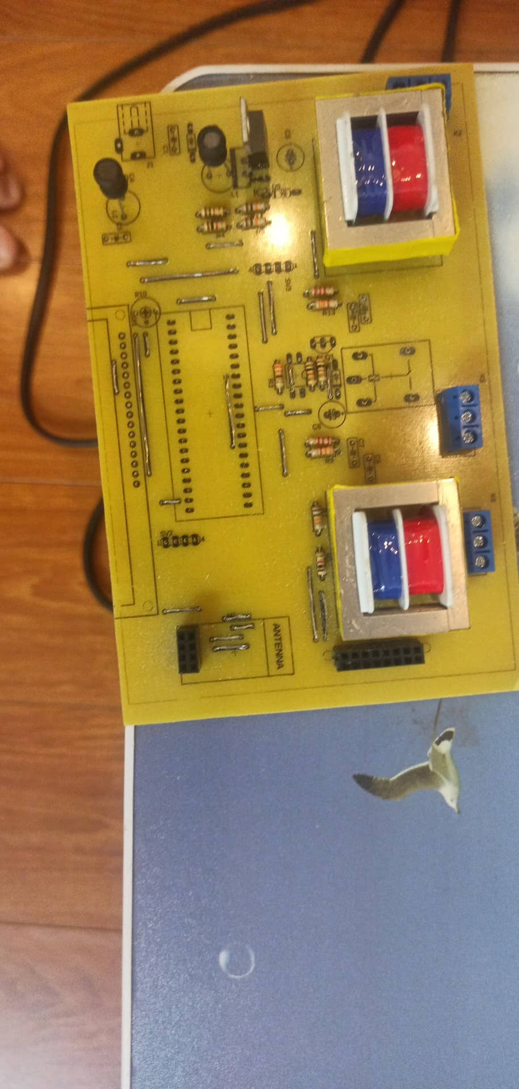
Image/Meter_pcb1.jpg
