deltax1099/DATN/Image/z3633697043855_0ed8bdc0d5988cb2e40bfdb945d06b9e.jpg

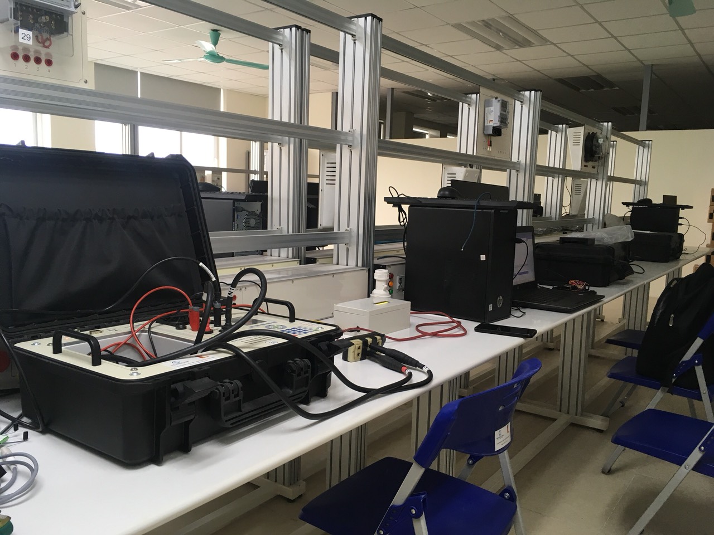
Image/z3633697043855_0ed8bdc0d5988cb2e40bfdb945d06b9e.jpg
