deltax1099/DATN/Image/z3633697054622_e3f382670f907069832cb71e8cc98d65.jpg

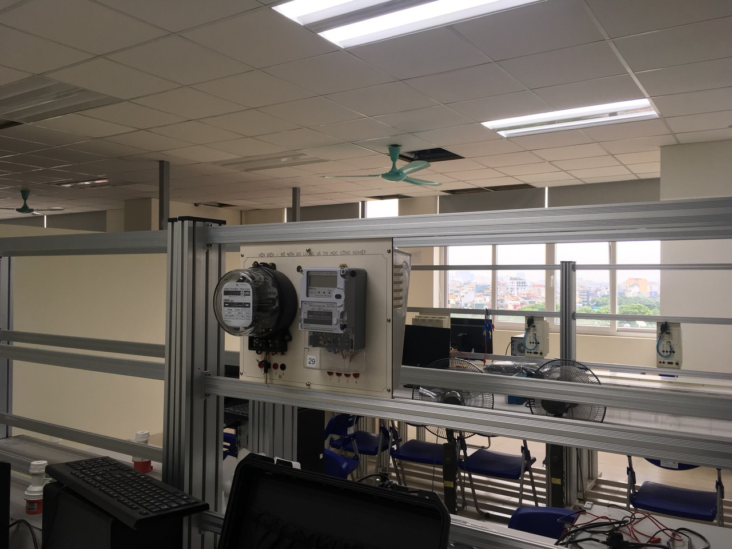
Image/z3633697054622_e3f382670f907069832cb71e8cc98d65.jpg
