deltax1099/DATN/Image/z3633697054730_deb0ce18a2755b18f67ec2cd3de1044d.jpg

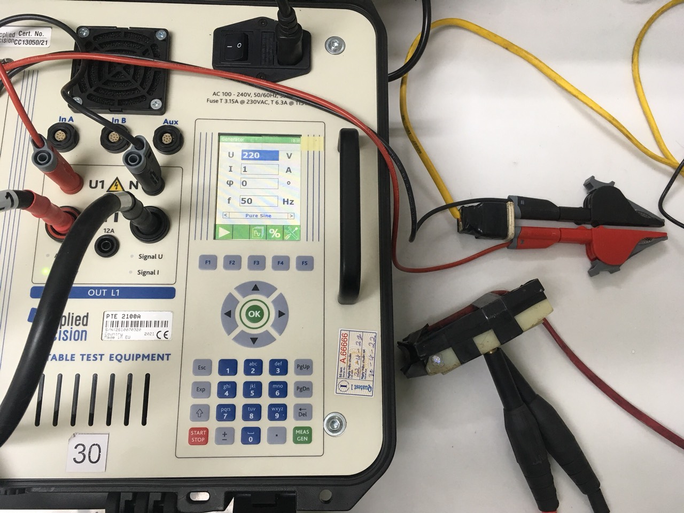
Image/z3633697054730_deb0ce18a2755b18f67ec2cd3de1044d.jpg
