deltax1099/DATN/Image/z3633697063974_3998b8c15f12cfb1844af8e6ffa5ab23.jpg

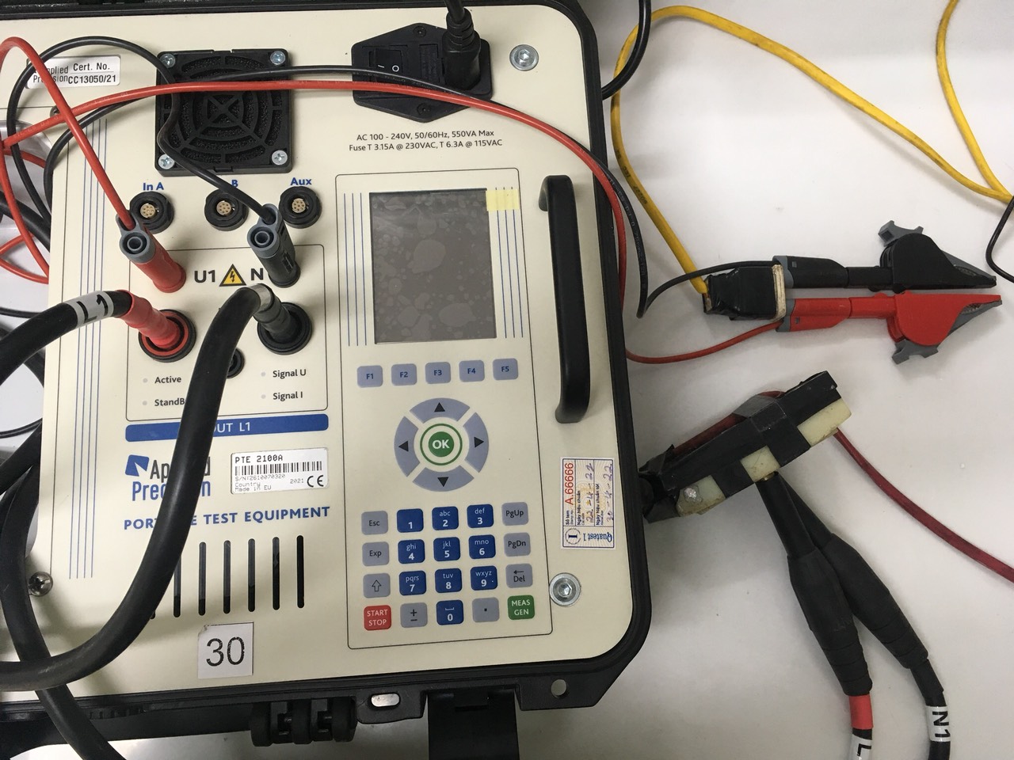
Image/z3633697063974_3998b8c15f12cfb1844af8e6ffa5ab23.jpg
