deltax1099/DATN/Image/z3633697194464_8e26a89eac70be727fcd39721a853901.jpg

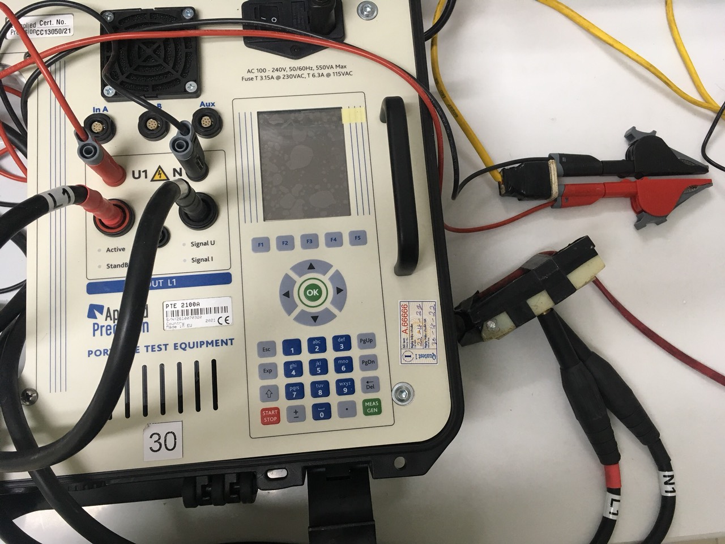
Image/z3633697194464_8e26a89eac70be727fcd39721a853901.jpg
