deltax1099/DATN/Image/z3633697253614_0a903c806f1cdf13b255be874b023d9c.jpg

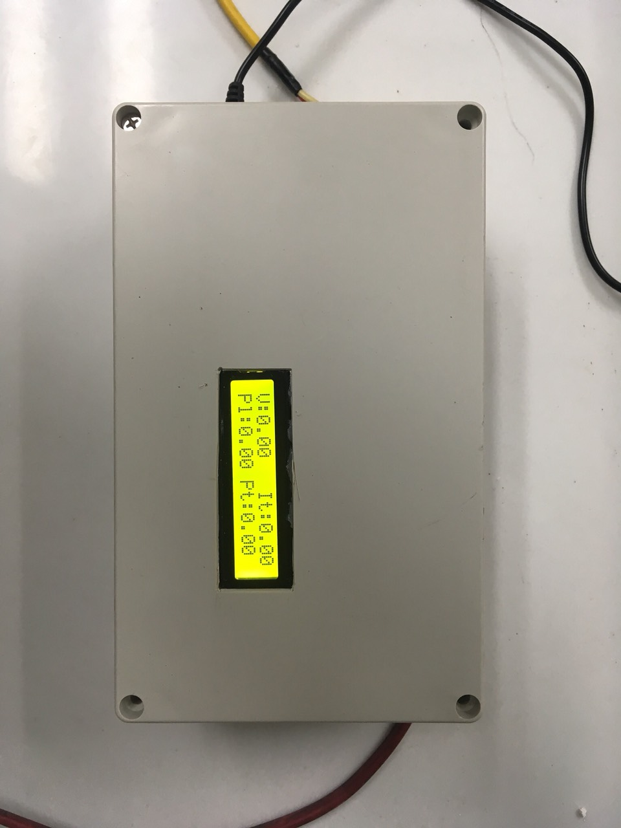
Image/z3633697253614_0a903c806f1cdf13b255be874b023d9c.jpg
