deltax1099/DATN/Image/z3633697329322_2b88db2f5381bdbda542137657a04bdd.jpg

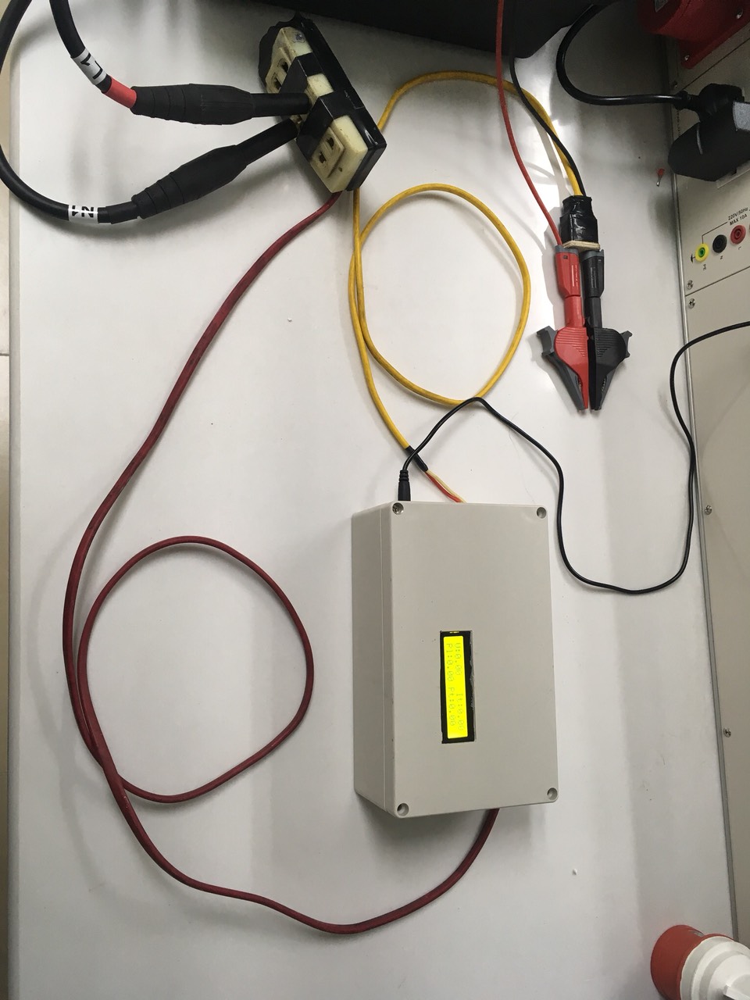
Image/z3633697329322_2b88db2f5381bdbda542137657a04bdd.jpg
