deltax1099/DATN/Image/z3633788703233_1b6939fd4be0bcd2386b87c643aee5f8.jpg

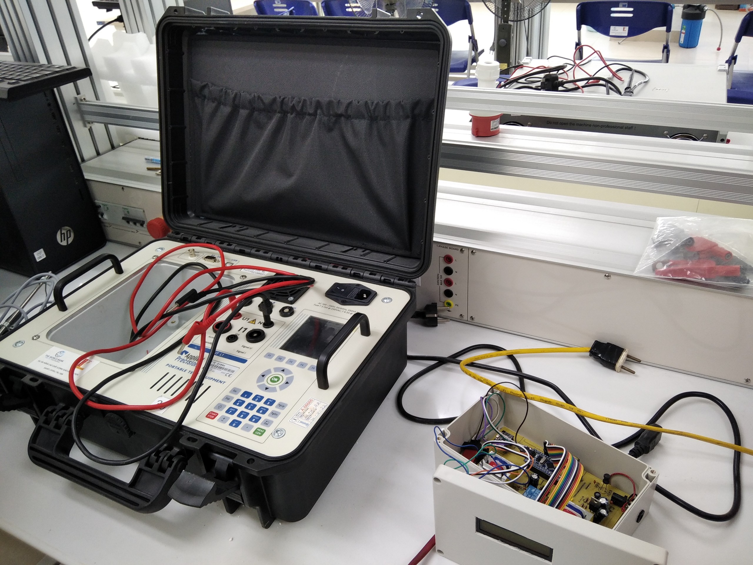
Image/z3633788703233_1b6939fd4be0bcd2386b87c643aee5f8.jpg
