deltax1099/DATN/Image/z3633788707510_45dfaa1e3b3302e267fcc52f2f358143.jpg

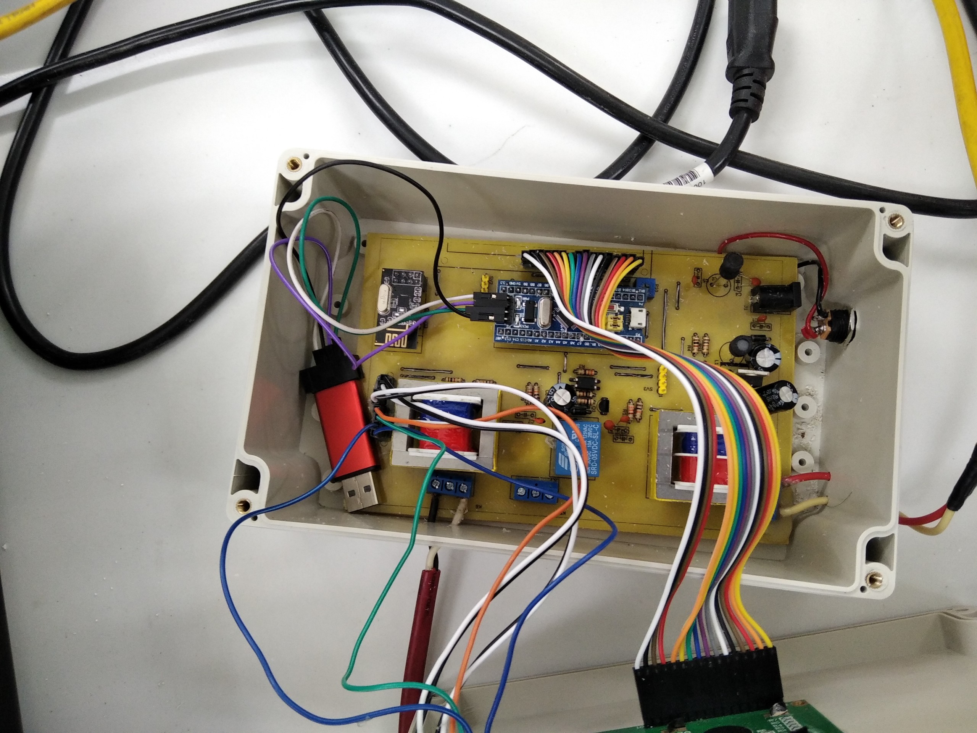
Image/z3633788707510_45dfaa1e3b3302e267fcc52f2f358143.jpg
