deltax1099/DATN/Image/z3633788713263_222394469bab1413b1b5b9986caa64b2.jpg

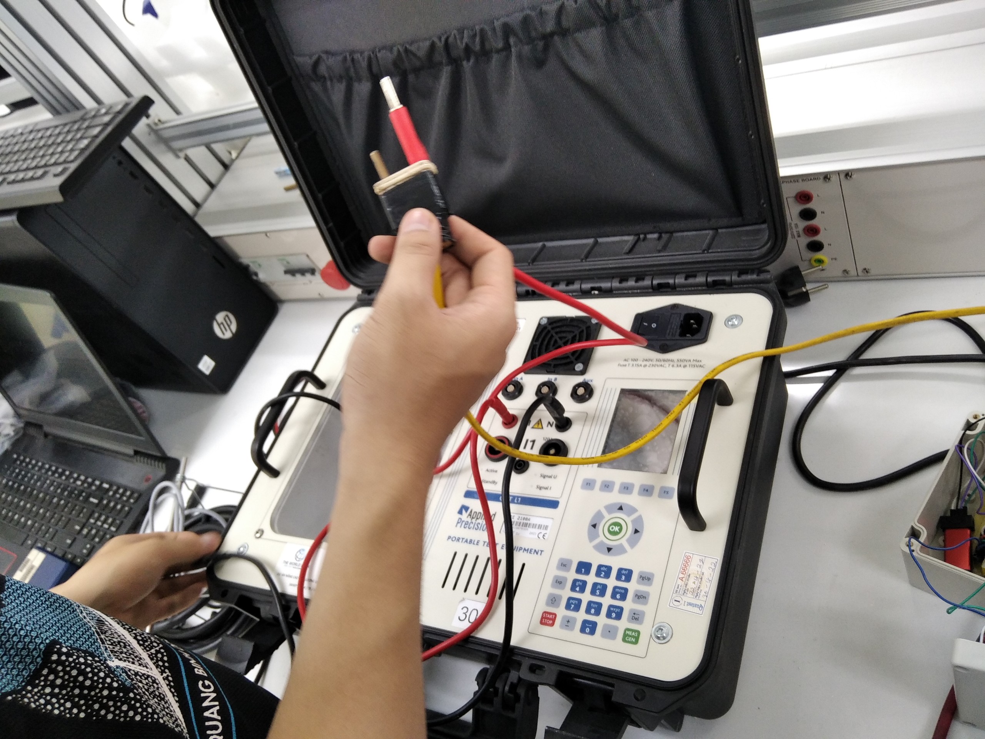
Image/z3633788713263_222394469bab1413b1b5b9986caa64b2.jpg
