deltax1099/DATN/Image/z3633788720598_30bdddbfec950afa14929e05105a0497.jpg

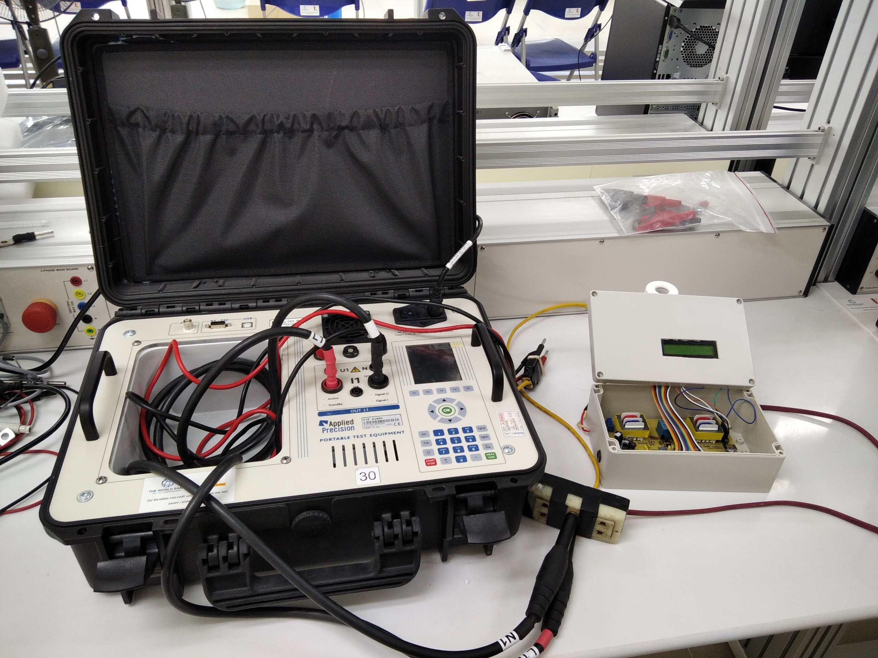
Image/z3633788720598_30bdddbfec950afa14929e05105a0497.jpg
