deltax1099/DATN/Image/z3633788724501_6bf4953d8cdc329f387bfd978f9d9a06.jpg

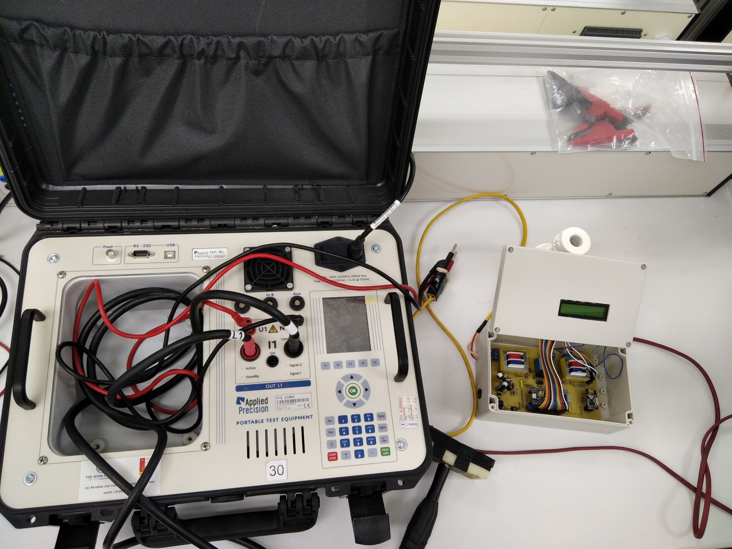
Image/z3633788724501_6bf4953d8cdc329f387bfd978f9d9a06.jpg
