deltax1099/DATN/Image/z3633788730689_87eaaf64714affc2c3887e92b721f934.jpg

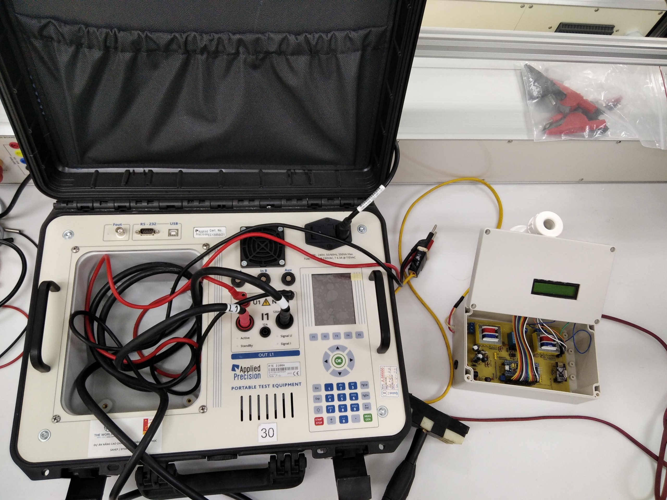
Image/z3633788730689_87eaaf64714affc2c3887e92b721f934.jpg
