deltax1099/DATN/Image/z3633788736517_664f7e3d3a5dba186977464a39618cd2.jpg

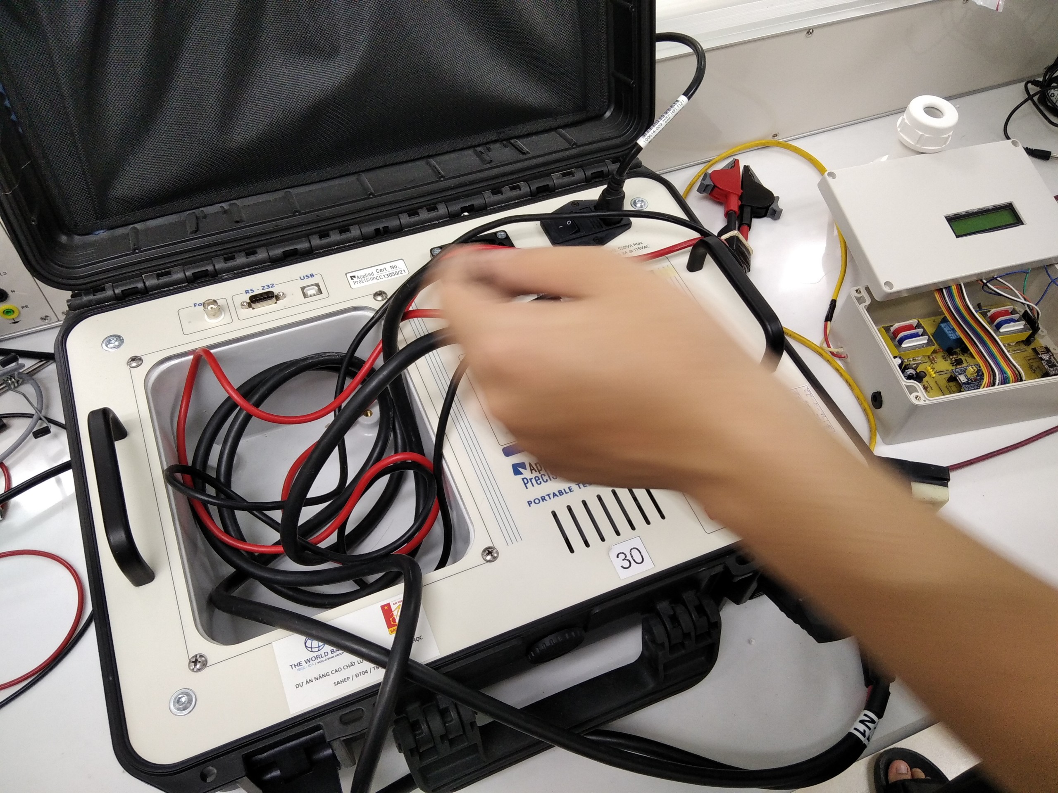
Image/z3633788736517_664f7e3d3a5dba186977464a39618cd2.jpg
