deltax1099/DATN/Image/z3633788739542_86100b4ee284c06ceaa1bb010aa74d50.jpg

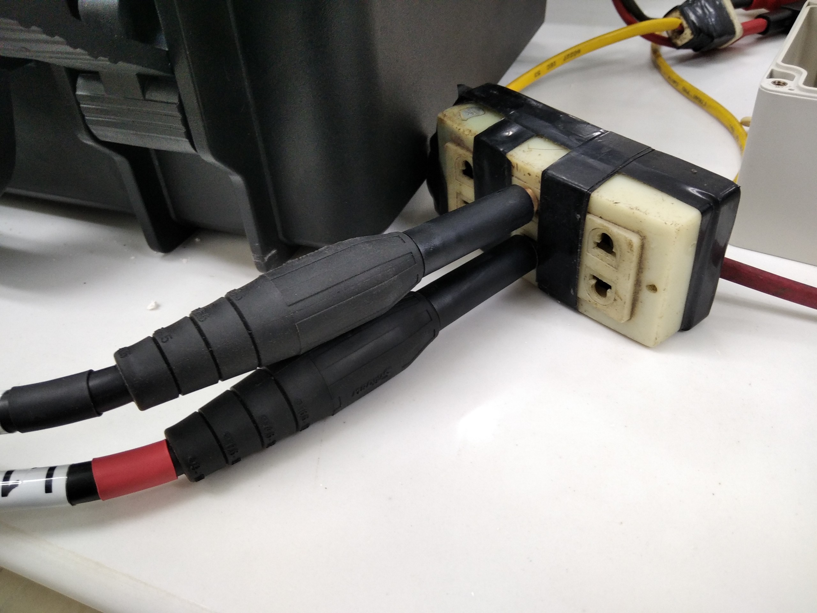
Image/z3633788739542_86100b4ee284c06ceaa1bb010aa74d50.jpg
