deltax1099/DATN/Image/z3633788747351_289867f49d6e5e890e34e75903090a8d.jpg

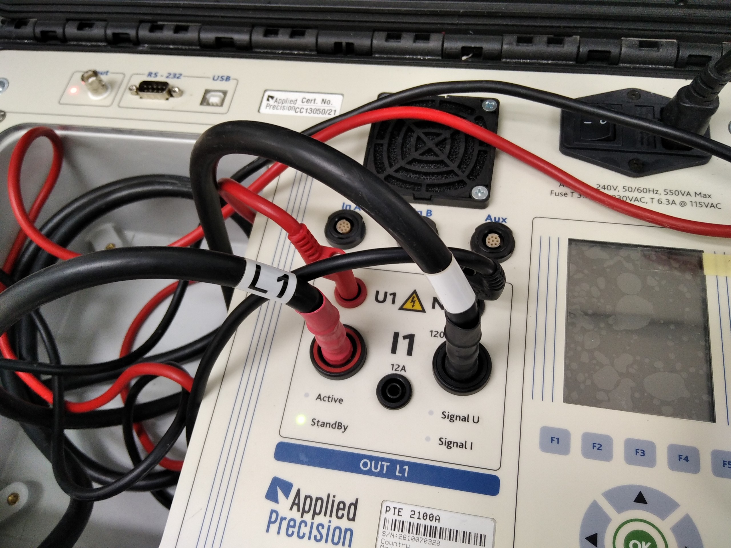
Image/z3633788747351_289867f49d6e5e890e34e75903090a8d.jpg
