deltax1099/DATN/Image/z3633788751047_a2f87b9e57f14d8752defe877e9a5675.jpg

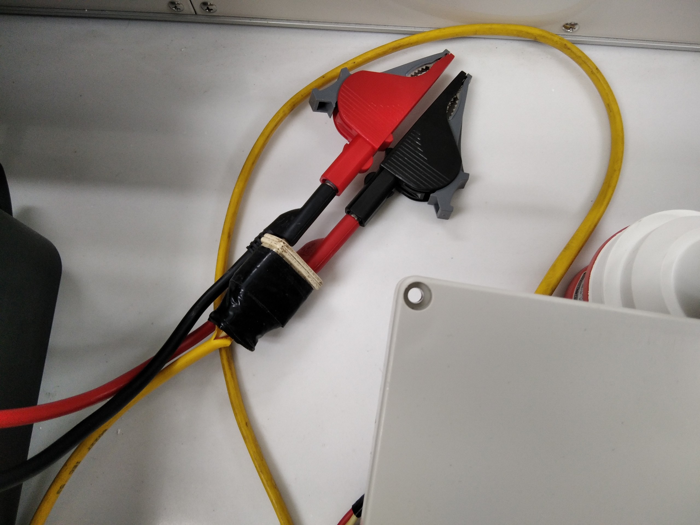
Image/z3633788751047_a2f87b9e57f14d8752defe877e9a5675.jpg
