deltax1099/DATN/Image/z3633788760179_7ca02a35863adaa0c0be559bdf0102b6.jpg

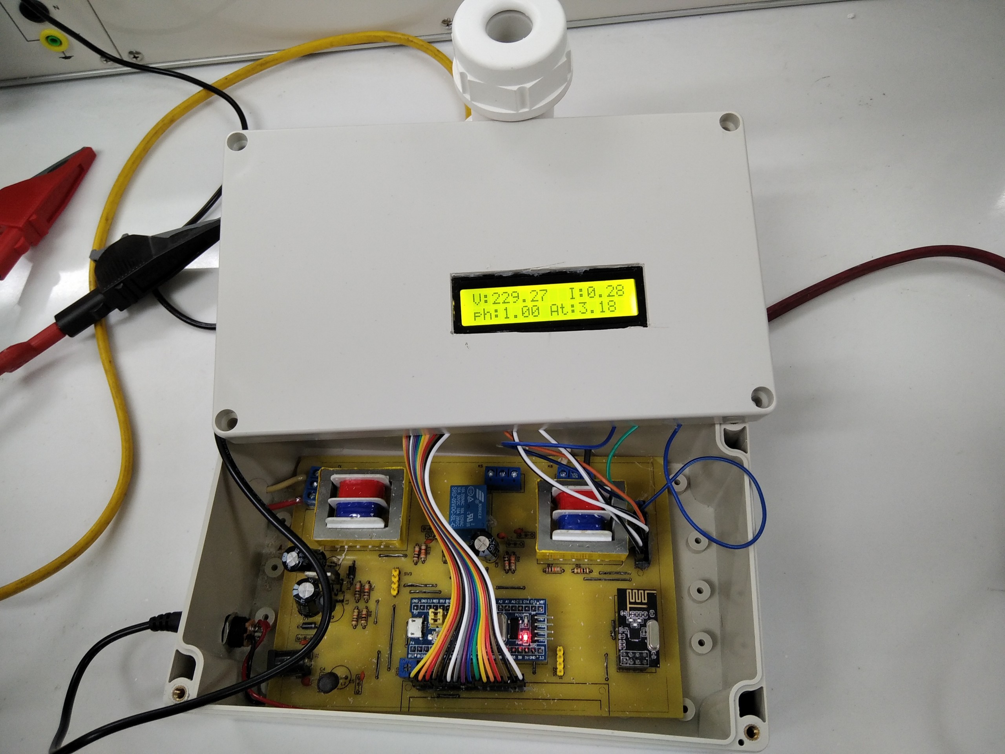
Image/z3633788760179_7ca02a35863adaa0c0be559bdf0102b6.jpg
