deltax1099/DATN/Image/z3633788865658_dbec1aaeeef71ed1d42e424d6eeba4fb.jpg

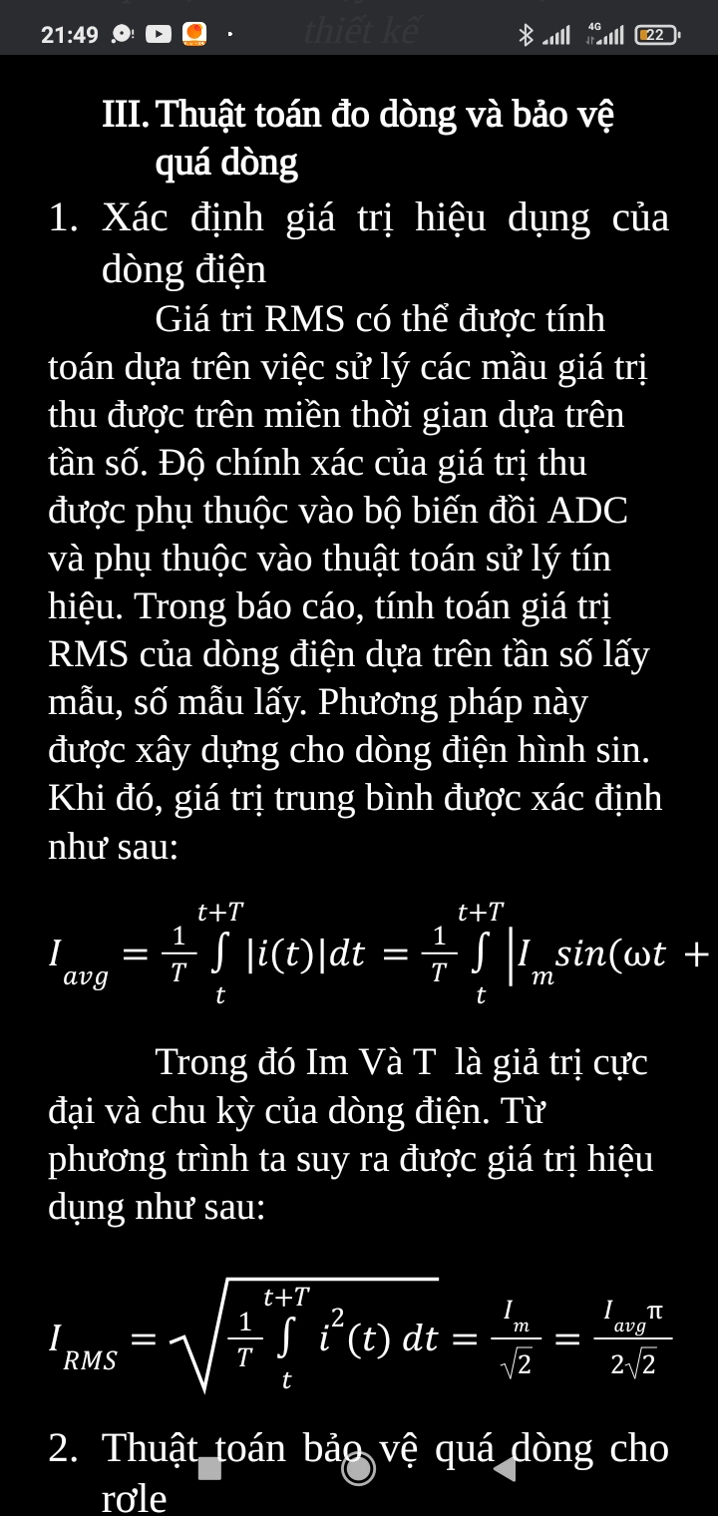
Image/z3633788865658_dbec1aaeeef71ed1d42e424d6eeba4fb.jpg
