deltax1099/DATN/Image/z3633788971723_21c7e0e327ba7d52e069c1e2cc720454.jpg

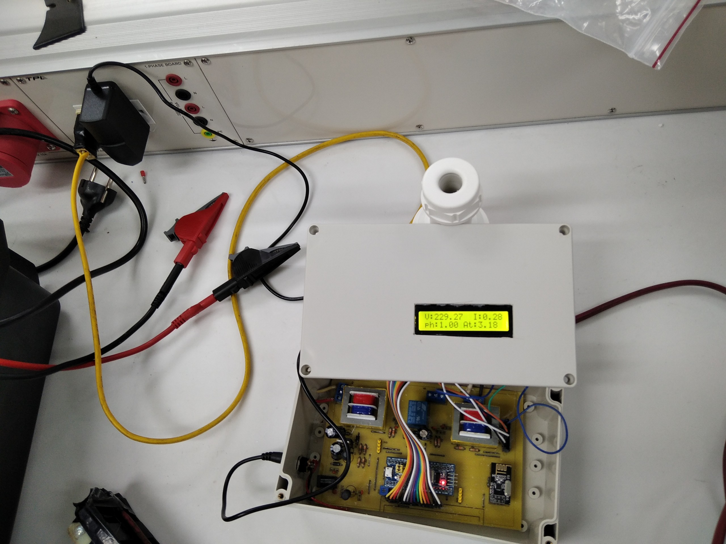
Image/z3633788971723_21c7e0e327ba7d52e069c1e2cc720454.jpg
