deltax1099/DATN/Image/z3633789237697_e2d45146eb43f4881944bb2823208427.jpg

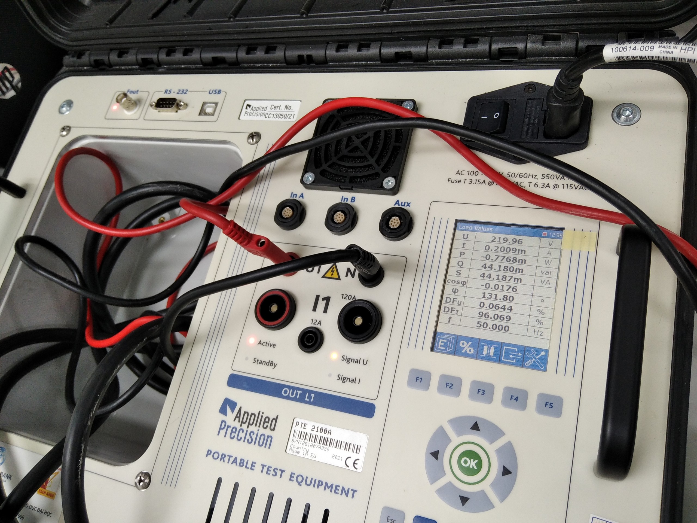
Image/z3633789237697_e2d45146eb43f4881944bb2823208427.jpg
