deltax1099/DATN/Image/z3633789354949_e994d4cc5071812628185963330143b5.jpg

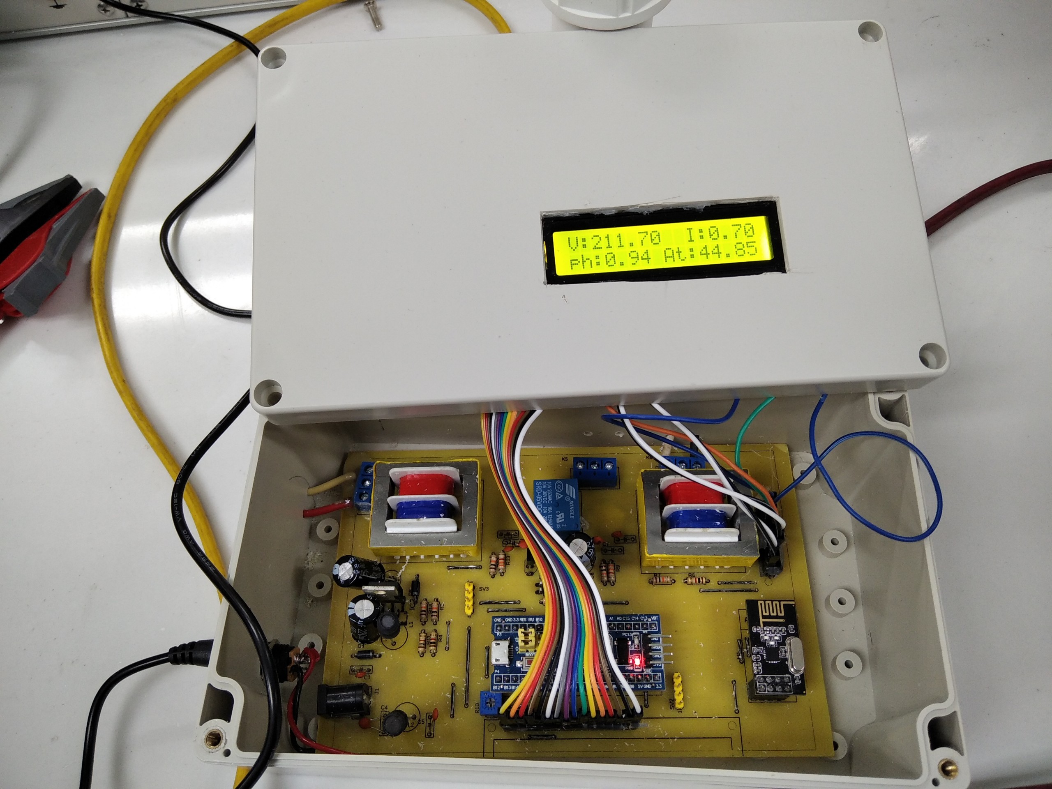
Image/z3633789354949_e994d4cc5071812628185963330143b5.jpg
