deltax1099/DATN/Image/z3633789682462_40a665bb13602b0477175627398cb576.jpg

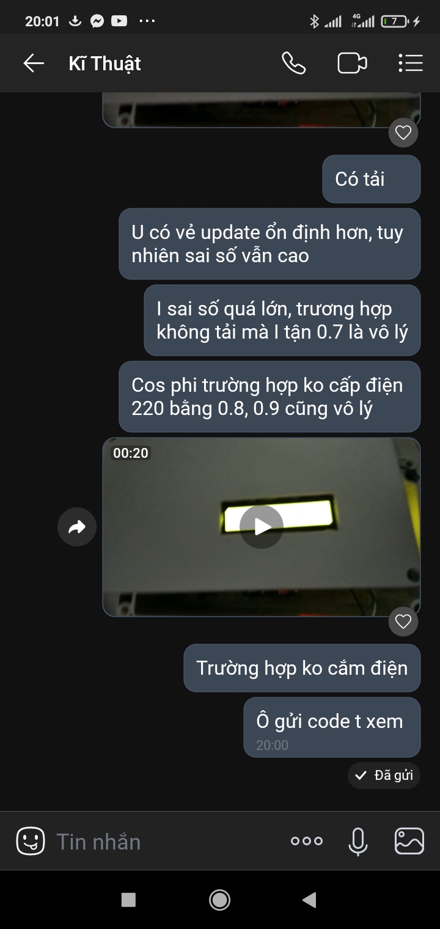
Image/z3633789682462_40a665bb13602b0477175627398cb576.jpg
