deltax1099/DATN/Image/z3633867237232_4345e2f27693feb337194435f79a0a52.jpg

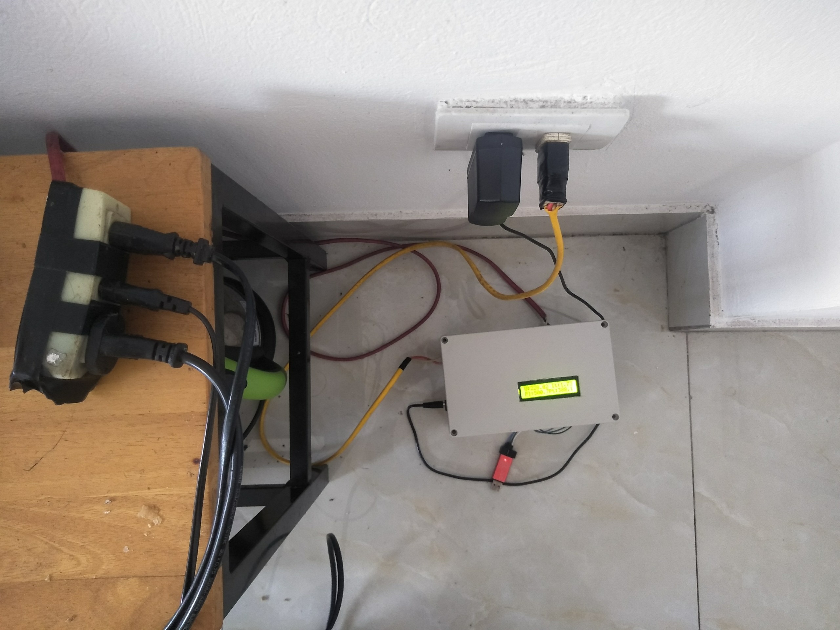
Image/z3633867237232_4345e2f27693feb337194435f79a0a52.jpg
