deltax1099/DATN/Image/z3633867240709_471236de816b5452bb44a05d84dc35d6.jpg

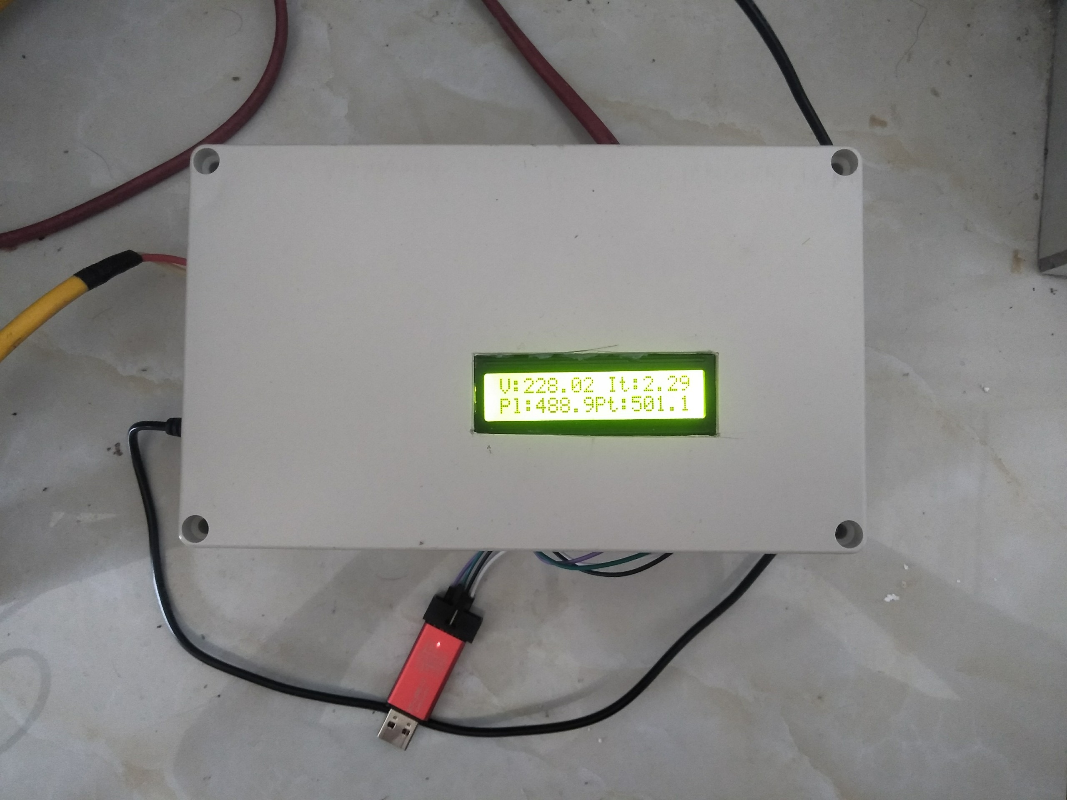
Image/z3633867240709_471236de816b5452bb44a05d84dc35d6.jpg
