deltax1099/DATN/Image/z3633867243439_04be78415b957eeec6fade286f10993e.jpg

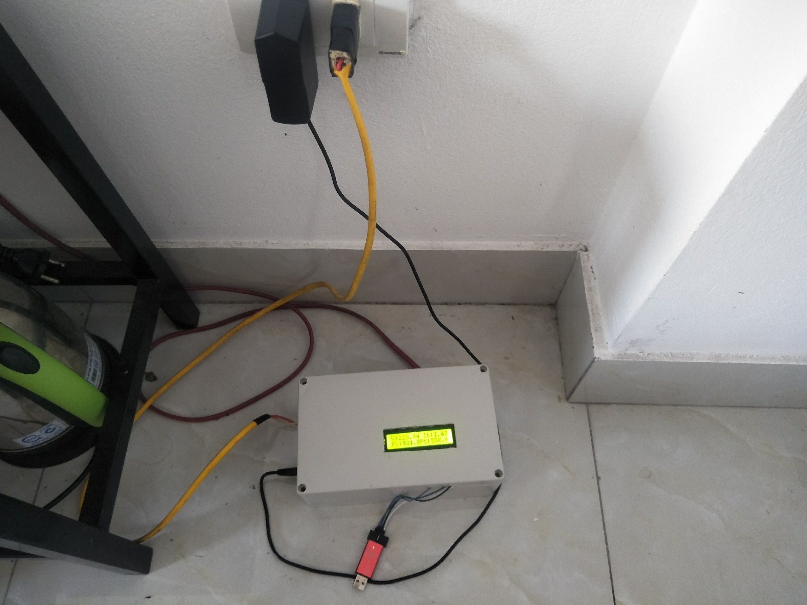
Image/z3633867243439_04be78415b957eeec6fade286f10993e.jpg
