deltax1099/DATN/Image/z3633867289374_f49f4a838da11998d1e43681a40d67f9.jpg

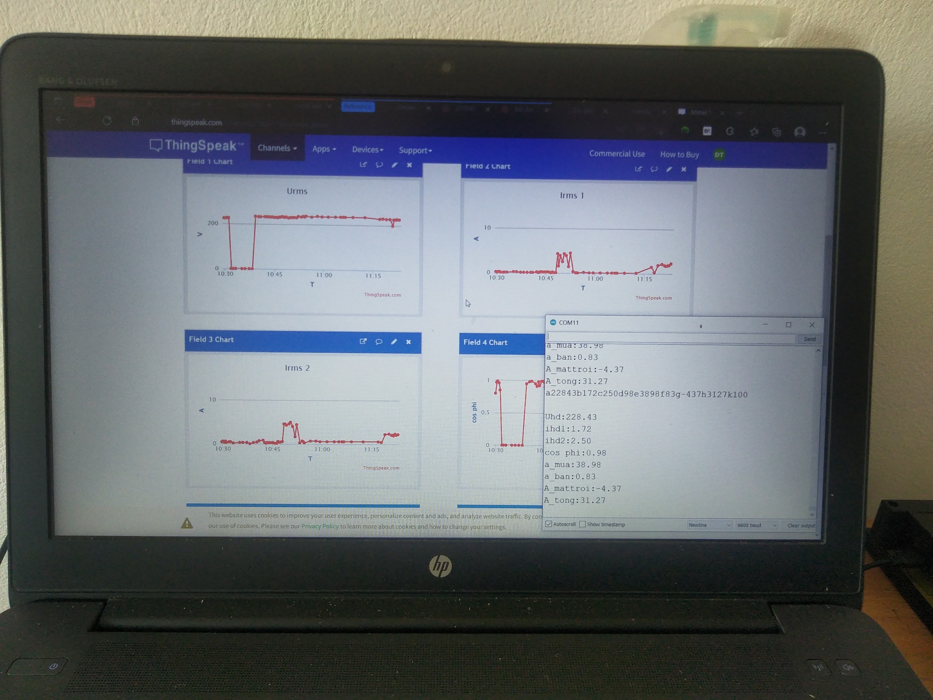
Image/z3633867289374_f49f4a838da11998d1e43681a40d67f9.jpg
