deltax1099/DATN/Image/z3633867296905_c56662ba91323b21be1d0efe046d9035.jpg

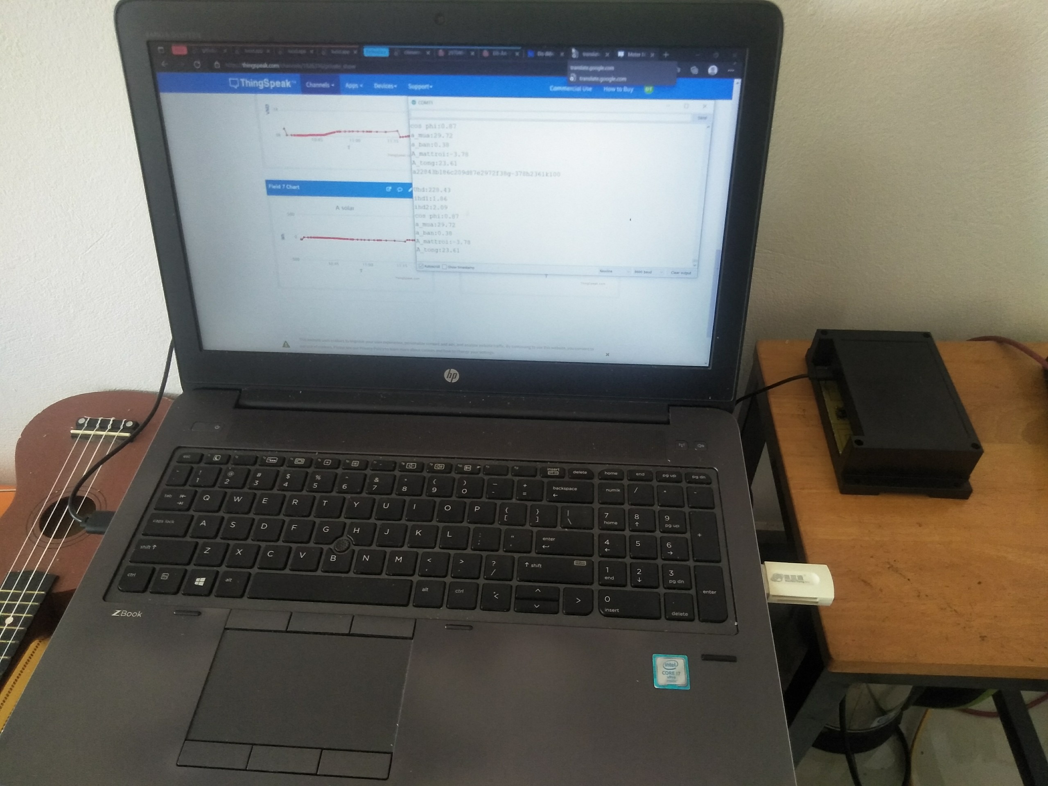
Image/z3633867296905_c56662ba91323b21be1d0efe046d9035.jpg
