deltax1099/DATN/Image/z3633867315102_5161dbb9b1df4a9272d84ef7197464c2.jpg

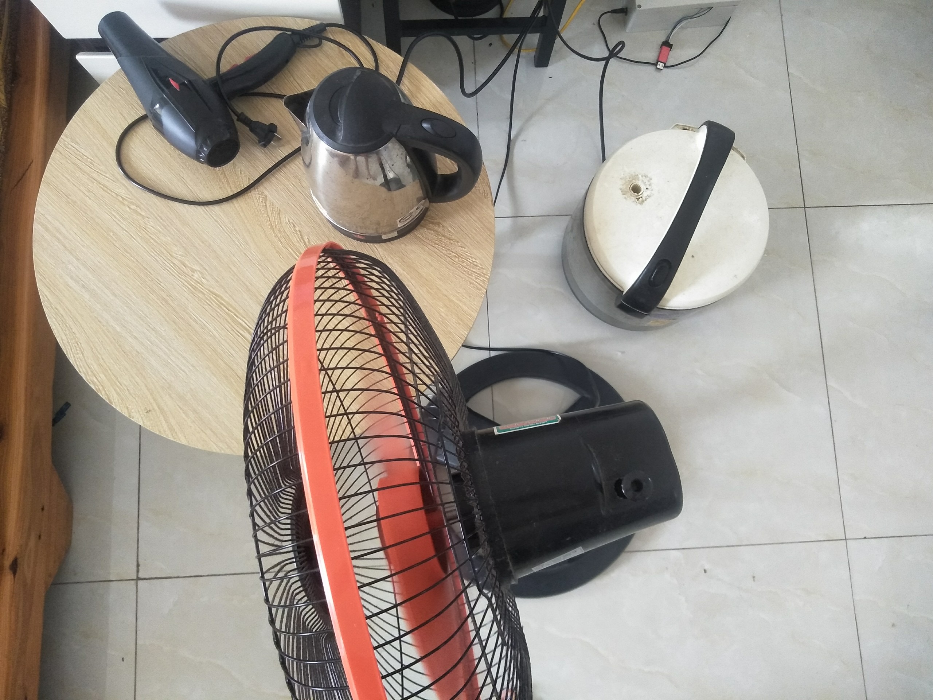
Image/z3633867315102_5161dbb9b1df4a9272d84ef7197464c2.jpg
