deltax1099/DATN/Hardware/stm32_c.brd

## EAGLE design Hardware/stm32_c.brd (2022-08-11)

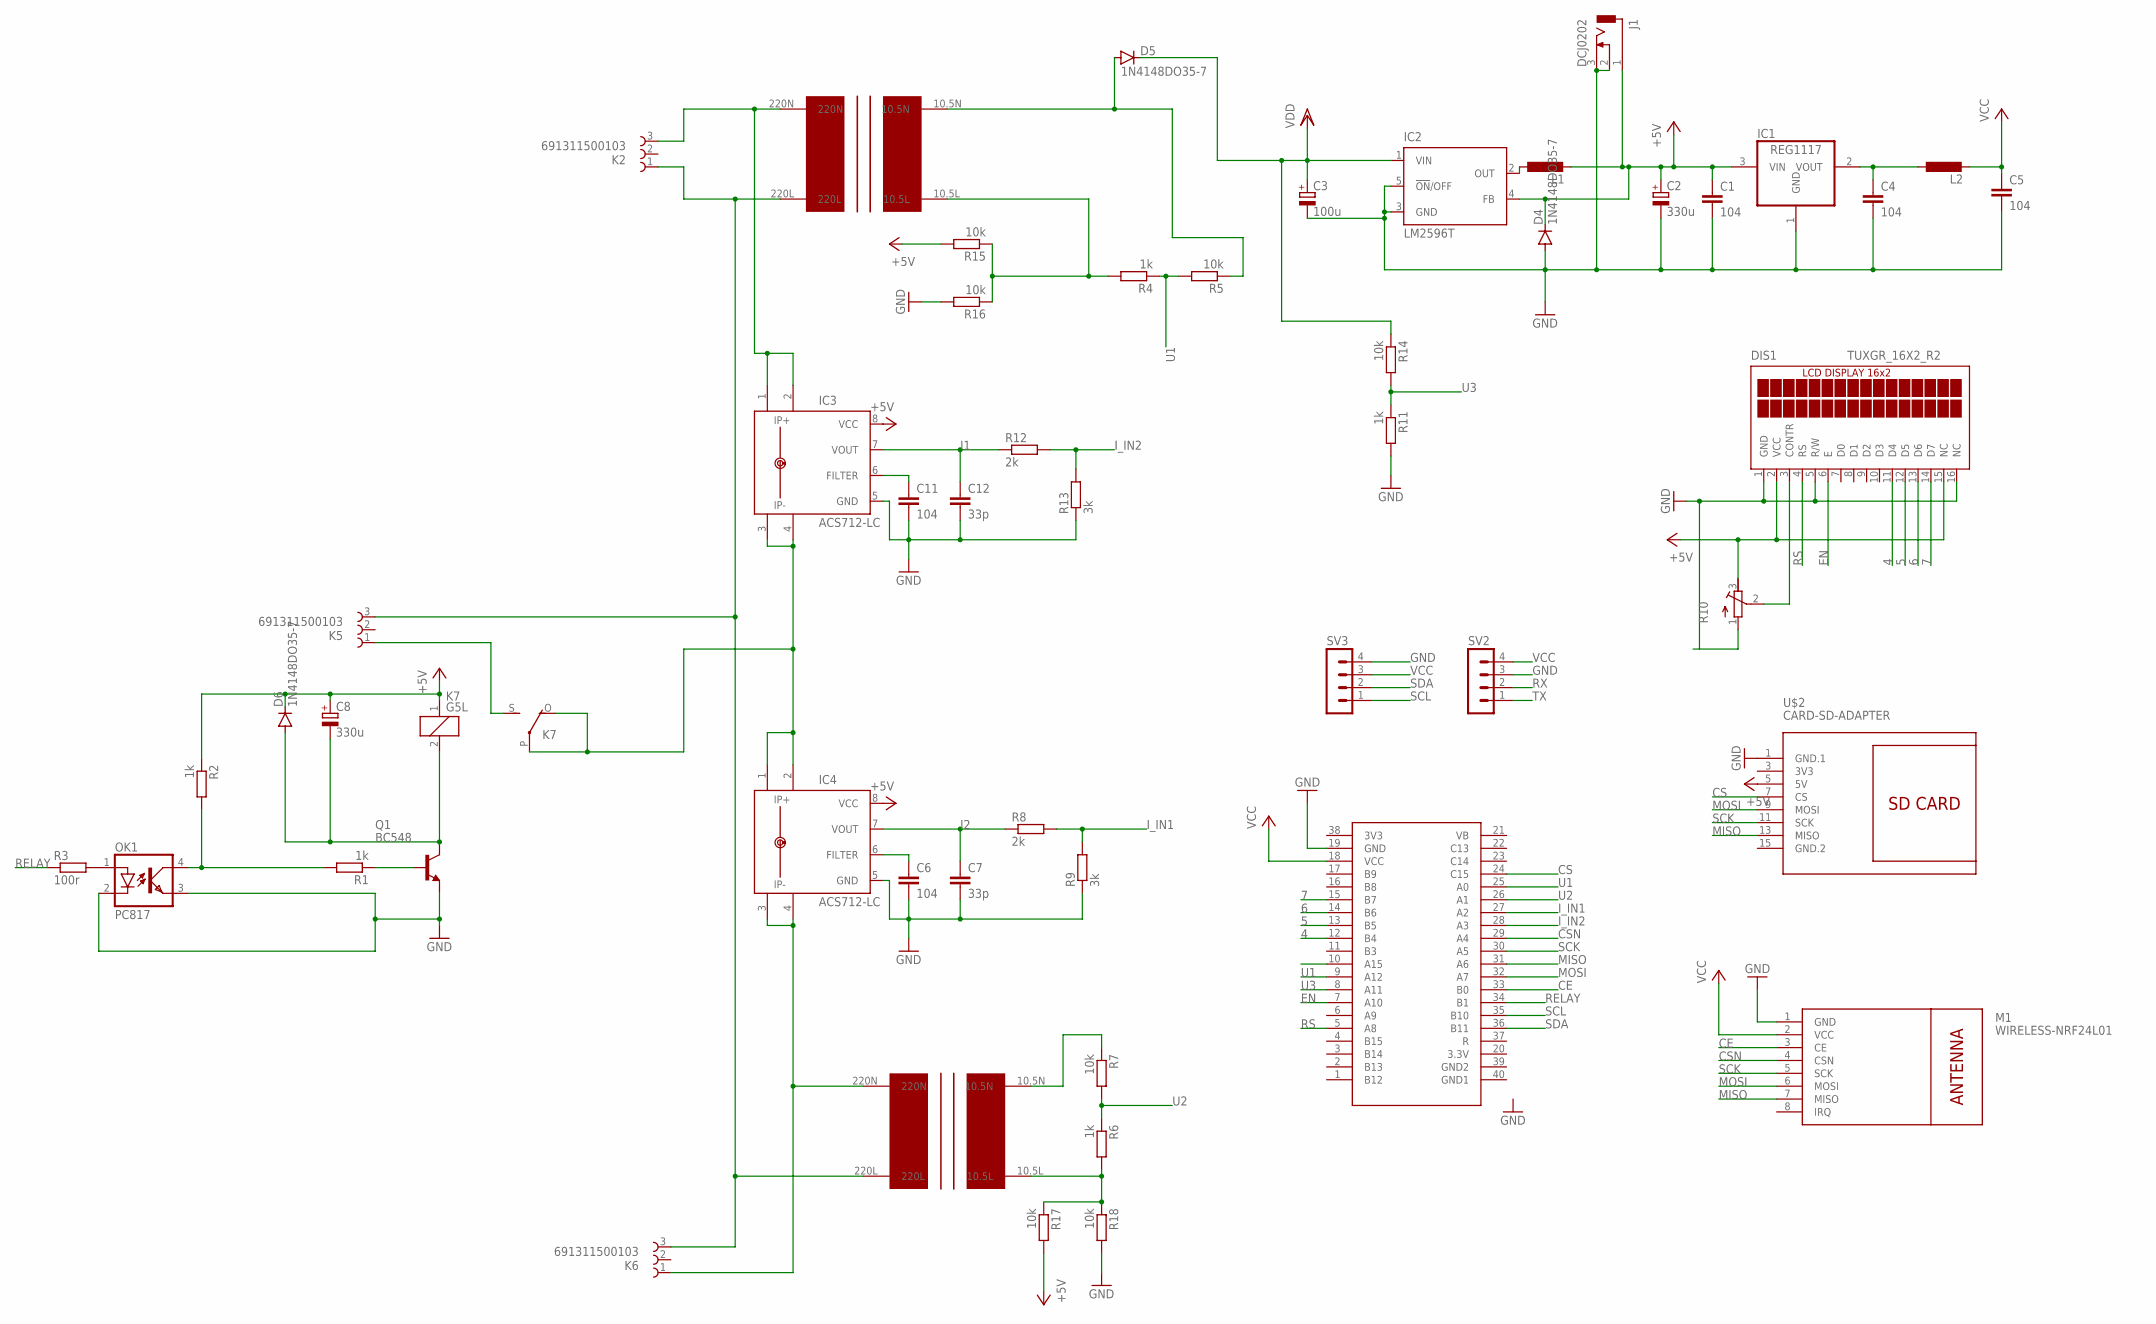
[picture p94: schematic stm32_c.sch]

Parts:
C1, C4, C5, C6, C11: 104; C050-025X075
C2, C8: 330u; E2,5-7
C3: 100u; E2,5-7
C7, C12: 33p; C050-025X075
D4, D5, D6: 1N4148DO35-7; DO35-7
DIS1: TUXGR_16X2_R2
IC1: REG1117; SOT223
IC2: LM2596T; T05D
IC3, IC4: ACS712-LC; SOIC8
J1: DCJ0202
K2, K5, K6: 691311500103
K7: G5L; G5LE
L1, L2: L-EU6000-XXX-RC; 6000-XXXX-RC
M1: WIRELESS-NRF24L01
OK1: PC817; DIL04
Q1: BC548; TO92-EBC
R1, R2, R4, R6, R11: 1k; 0207/7
R3: 100r; 0207/7
R5, R7, R14, R15, R16, R17, R18: 10k; 0207/7
R8, R12: 2k; 0207/7
R9, R13: 3k; 0207/7
R10: R-TRIMM3339P; RTRIM3339P
SV2, SV3: MA04-1
U$1: KIT_STM32F103
U$2: CARD-SD-ADAPTER
U$3, U$4: BIENAP(10.5)_BIEN_AP

Connections:
3V3: U$2.3 (3V3)
4: DIS1.11 (D4), U$1.12 (B4)
5: DIS1.12 (D5), U$1.13 (B5)
6: DIS1.13 (D6), U$1.14 (B6)
7: DIS1.14 (D7), U$1.15 (B7)
+5V: C1.1, C2.+, C8.+, D4.C, D6.C, DIS1.2 (VCC), DIS1.15 (NC), IC1.3 (VIN), IC2.4 (FB), IC3.8 (VCC), IC4.8 (VCC), J1.1, K7.1, L1.2, R2.1, R10.3 (E), R15.2, R17.2, U$2.5 (5V)
CE: M1.3 (CE), U$1.33 (B0)
CS: U$1.24 (C15), U$2.7 (CS)
CSN: M1.4 (CSN), U$1.29 (A4)
EN: DIS1.6 (E), U$1.7 (A10)
GND: C1.2, C2.-, C3.-, C4.2, C5.2, C6.2, C7.2, C11.2, C12.2, D4.A, DIS1.1 (GND), DIS1.5 (R/W), DIS1.16 (NC), IC1.1 (GND), IC2.3 (GND), IC2.5 (!ON!/OFF), IC3.5 (GND), IC4.5 (GND), J1.2, J1.3, M1.1 (GND), OK1.2 (C), OK1.3 (EMIT), Q1.E, R9.1, R10.1 (A), R11.2, R13.1, R16.2, R18.2, SV2.3, SV3.4, U$1.19 (GND), U$2.1 (GND.1)
GND.2: U$2.15 (GND.2)
I1: C12.1, IC3.7 (VOUT), R12.1
I2: C7.1, IC4.7 (VOUT), R8.1
I_IN1: R8.2, R9.2, U$1.27 (A2)
I_IN2: R12.2, R13.2, U$1.28 (A3)
MISO: M1.7 (MISO), U$1.31 (A6), U$2.13 (MISO)
MOSI: M1.6 (MOSI), U$1.32 (A7), U$2.9 (MOSI)
unnamed: DIS1.3 (CONTR), R10.2 (S)
unnamed: C4.1, IC1.2 (VOUT), L2.1
unnamed: IC3.1 (IP+), IC3.2 (IP+1), K2.3, U$3.220N
unnamed: R4.2, R15.1, R16.1, U$3.10.5L
unnamed: D5.A, R5.1, U$3.10.5N
unnamed: IC3.3 (IP-), IC3.4 (IP-1), IC4.1 (IP+), IC4.2 (IP+1), K7.O, K7.P
unnamed: C6.1, IC4.6 (FILTER)
unnamed: IC2.2 (OUT), L1.1
unnamed: R6.2, R17.1, R18.1, U$4.10.5L
unnamed: K5.1, K7.S
unnamed: Q1.B, R1.1
unnamed: C8.-, D6.A, K7.2, Q1.C
unnamed: OK1.4 (COL), R1.2, R2.2
unnamed: IC4.3 (IP-), IC4.4 (IP-1), K6.1, U$4.220N
unnamed: OK1.1 (A), R3.2
unnamed: K2.1, K5.3, K6.3, U$3.220L, U$4.220L
unnamed: R7.1, U$4.10.5N
unnamed: C11.1, IC3.6 (FILTER)
RELAY: R3.1, U$1.34 (B1)
RS: DIS1.4 (RS), U$1.5 (A8)
RX: SV2.2
SCK: M1.5 (SCK), U$1.30 (A5), U$2.11 (SCK)
SCL: SV3.1, U$1.35 (B10)
SDA: SV3.2, U$1.36 (B11)
TX: SV2.1
U1: R4.1, R5.2, U$1.9 (A12), U$1.25 (A0)
U2: R6.1, R7.2, U$1.26 (A1)
U3: R11.1, R14.2, U$1.8 (A11)
VCC: C5.1, L2.2, M1.2 (VCC), SV2.4, SV3.3, U$1.18 (VCC)
VDD: C3.+, D5.C, IC2.1 (VIN), R14.1

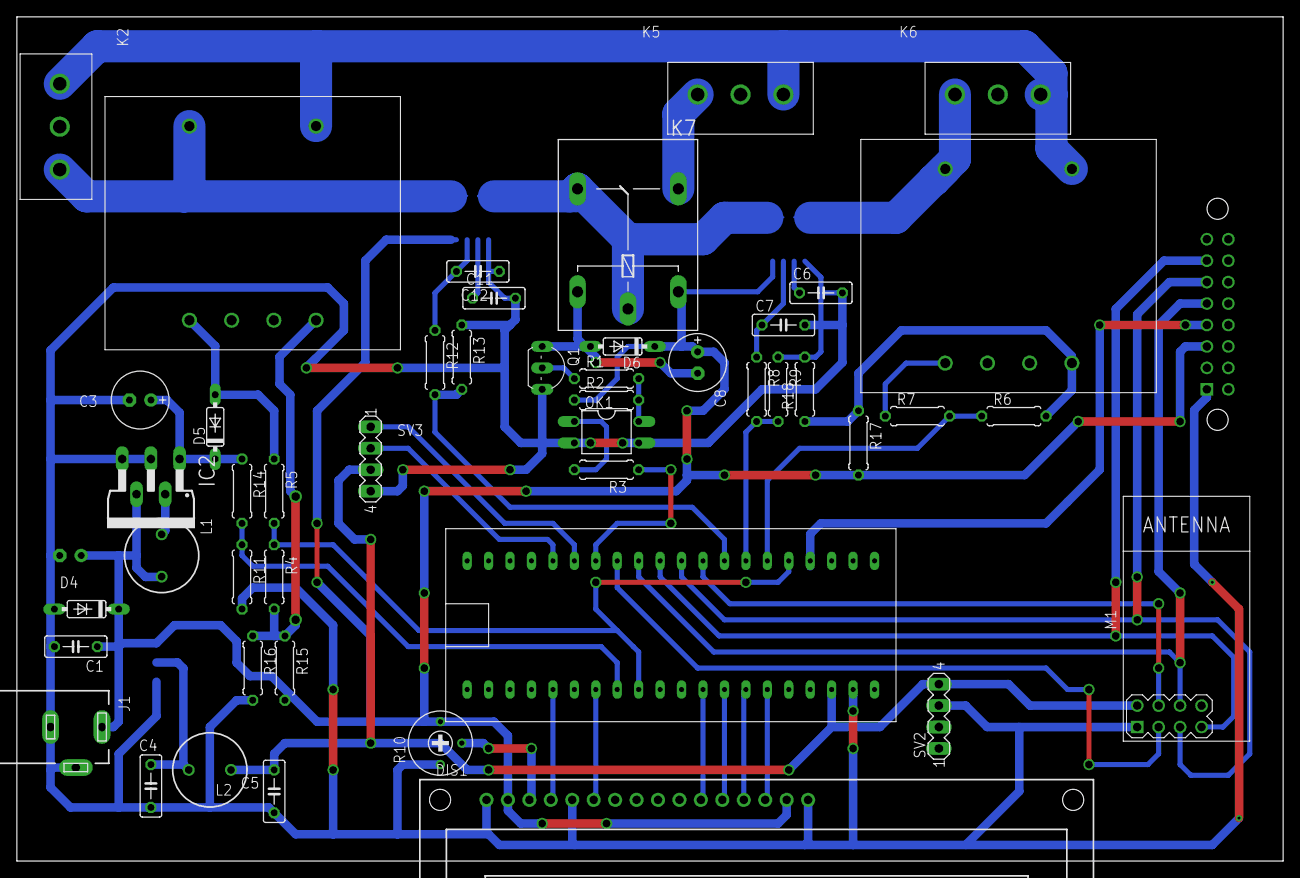
[picture p95: board stm32_c.brd from above]

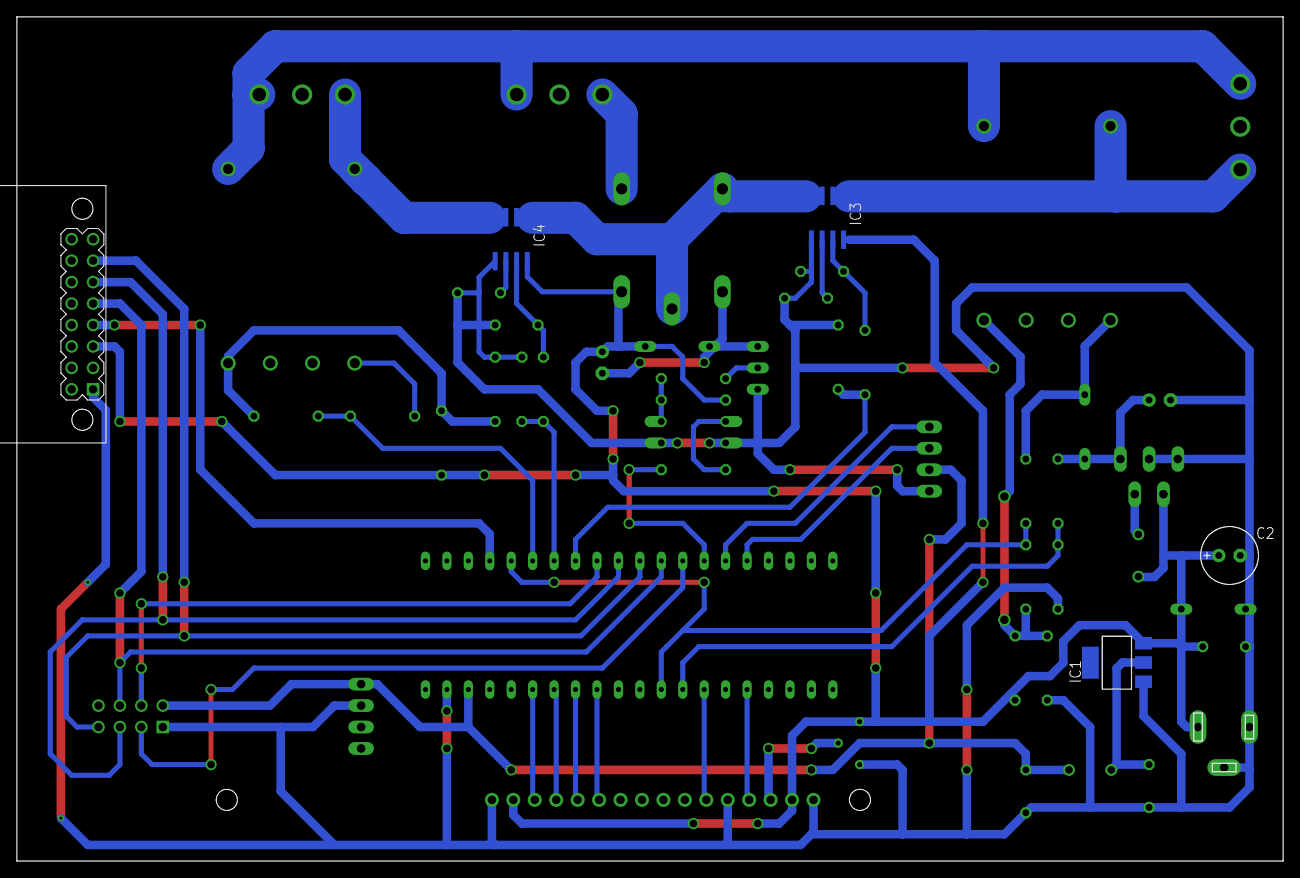
[picture p96: board stm32_c.brd from below]

Board: 2 copper layers, 150.0 x 100.0 mm, 52 parts (5 on the bottom side), 44 nets.
