deltax1099/DATN/Hardware/esp8266.brd

## EAGLE design Hardware/esp8266.brd (2022-08-05)

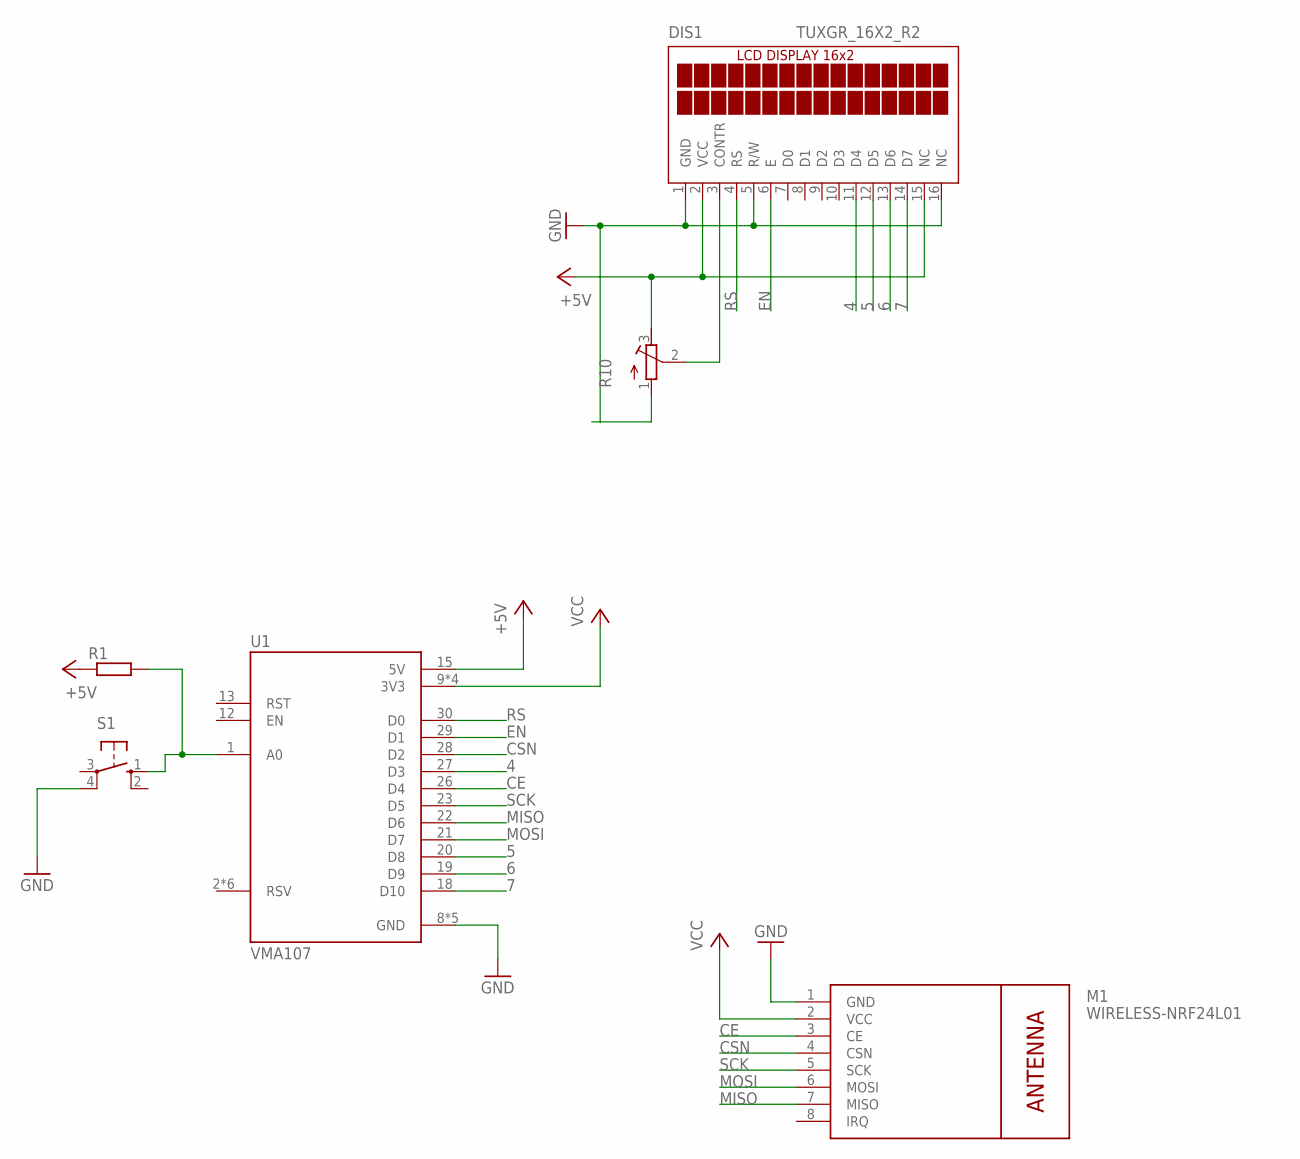
[picture p97: schematic esp8266.sch]

Parts:
DIS1: TUXGR_16X2_R2
M1: WIRELESS-NRF24L01
R1: R-EU_0207/7; 0207/7
R10: R-TRIMM3339P; RTRIM3339P
S1: 10-XX; B3F-10XX
U1: VMA107; MODULE_VMA107

Connections:
4: DIS1.11 (D4), U1.27 (D3)
5: DIS1.12 (D5), U1.20 (D8)
6: DIS1.13 (D6), U1.19 (D9)
7: DIS1.14 (D7), U1.18 (D10)
+5V: DIS1.2 (VCC), DIS1.15 (NC), R1.1, R10.3 (E), U1.15 (5V)
CE: M1.3 (CE), U1.26 (D4)
CSN: M1.4 (CSN), U1.28 (D2)
EN: DIS1.6 (E), U1.29 (D1)
GND: DIS1.1 (GND), DIS1.5 (R/W), DIS1.16 (NC), M1.1 (GND), R10.1 (A), S1.4 (P1), U1.8 (GND), U1.10 (GND), U1.14 (GND), U1.17 (GND), U1.24 (GND)
MISO: M1.7 (MISO), U1.22 (D6)
MOSI: M1.6 (MOSI), U1.21 (D7)
unnamed: DIS1.3 (CONTR), R10.2 (S)
unnamed: R1.2, S1.1 (S), U1.1 (A0)
RS: DIS1.4 (RS), U1.30 (D0)
SCK: M1.5 (SCK), U1.23 (D5)
VCC: M1.2 (VCC), U1.9 (3V3), U1.11 (3V3), U1.16 (3V3), U1.25 (3V3)

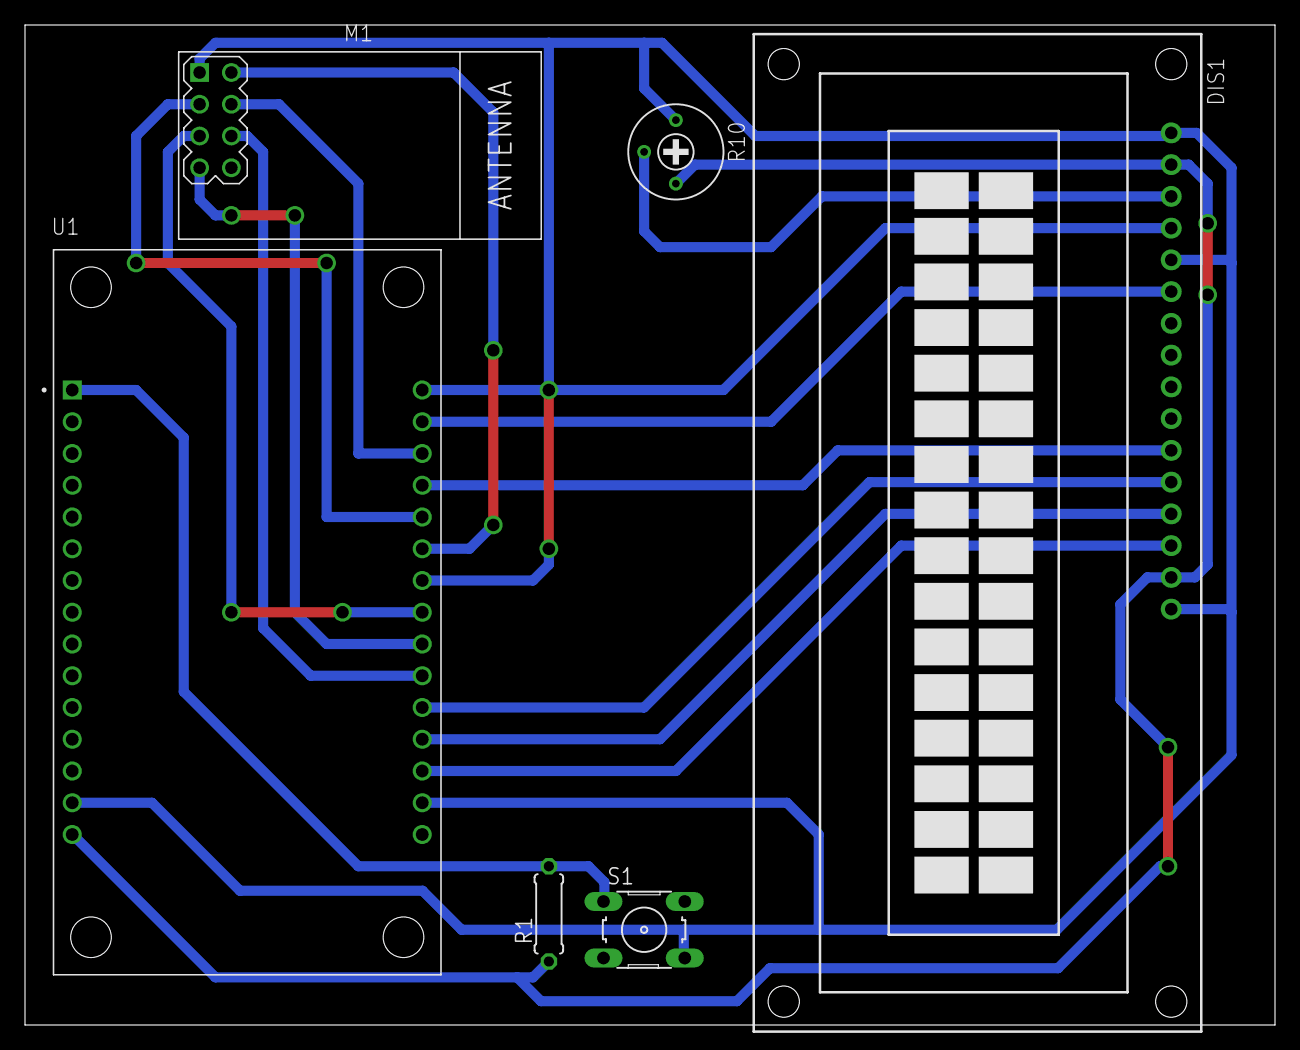
[picture p98: board esp8266.brd from above]

Board: 2 copper layers, 100.0 x 80.0 mm, 6 parts (0 on the bottom side), 16 nets.
