deltax1099/DATN/(commit log)

2022-08-05 Add sch and pcb
    [esp8266.brd, esp8266.sch, stm32.brd, stm32.sch]
2022-08-05 modify doc and add image
    [esp8266.sch]
2022-08-11 go hard go hard
    [feeds.csv, stm32_c.brd, stm32_c.sch]
