deltax1099/DATN/(notices)

Notices in the files:
parts and their libraries:
Wurth_Elektronik_Electromechanic_Termina: Copyright: Würth Elektronik
diy-modules: Released under the Creative Commons Attribution 4.0 International License: http://creativecommons.org/licenses/by/4.0
